Alektooo-222/zynq7020_ddr3_learning_board/(list of files, drawings)

Other design files:
DFTBoard.dsn
