Alektooo-222/zynq7020_ddr3_learning_board/DFTBoard.kicad_pcb

## KiCad design DFTBoard.kicad_pcb (2026-11-10)

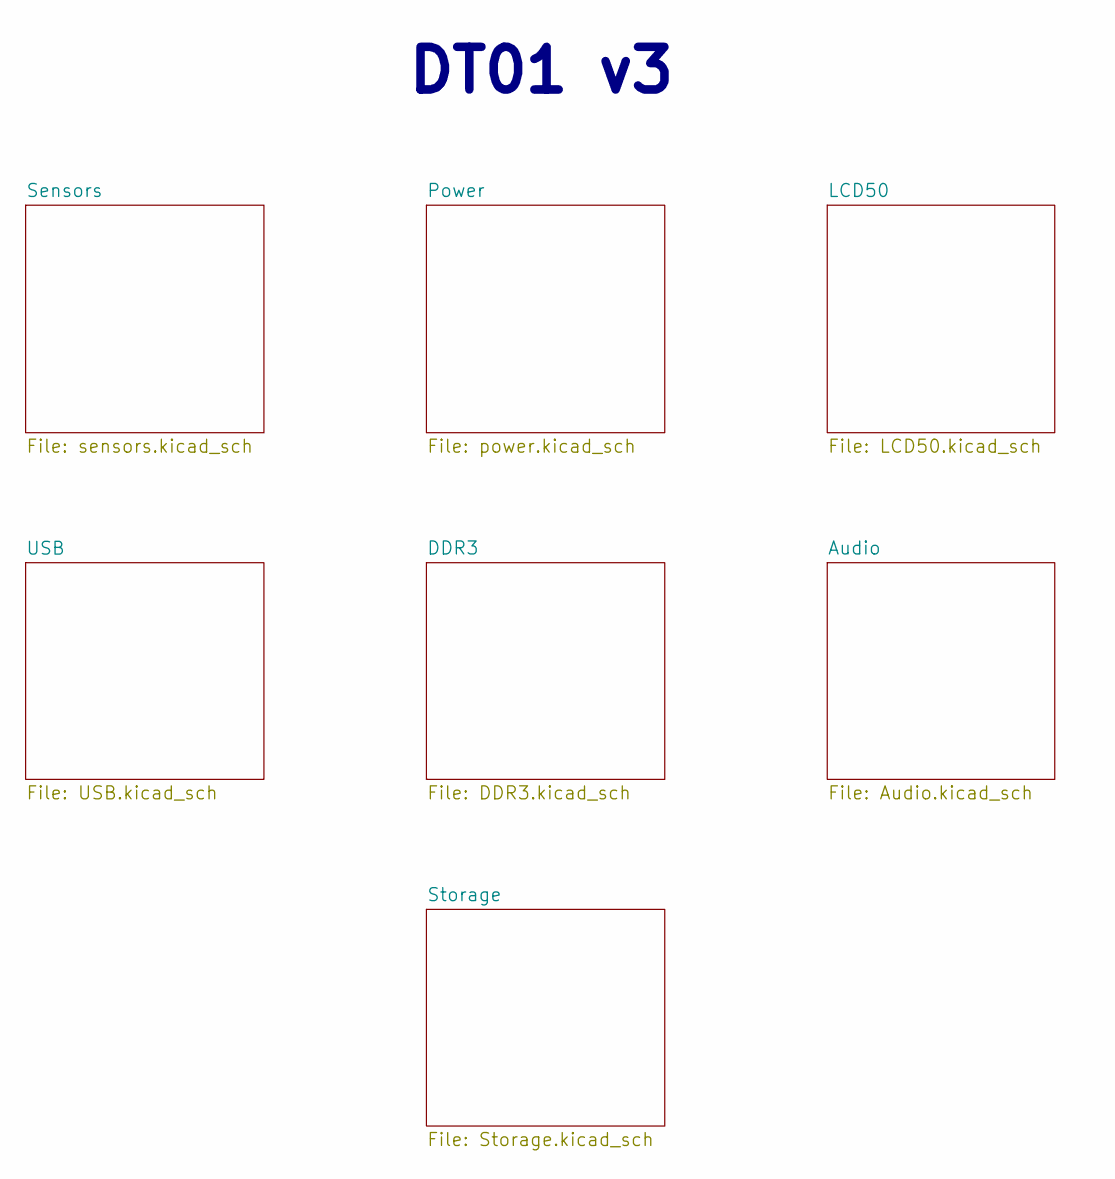
[picture p3: schematic DFTBoard.kicad_sch]

Notes on the sheet:
DT01 v3

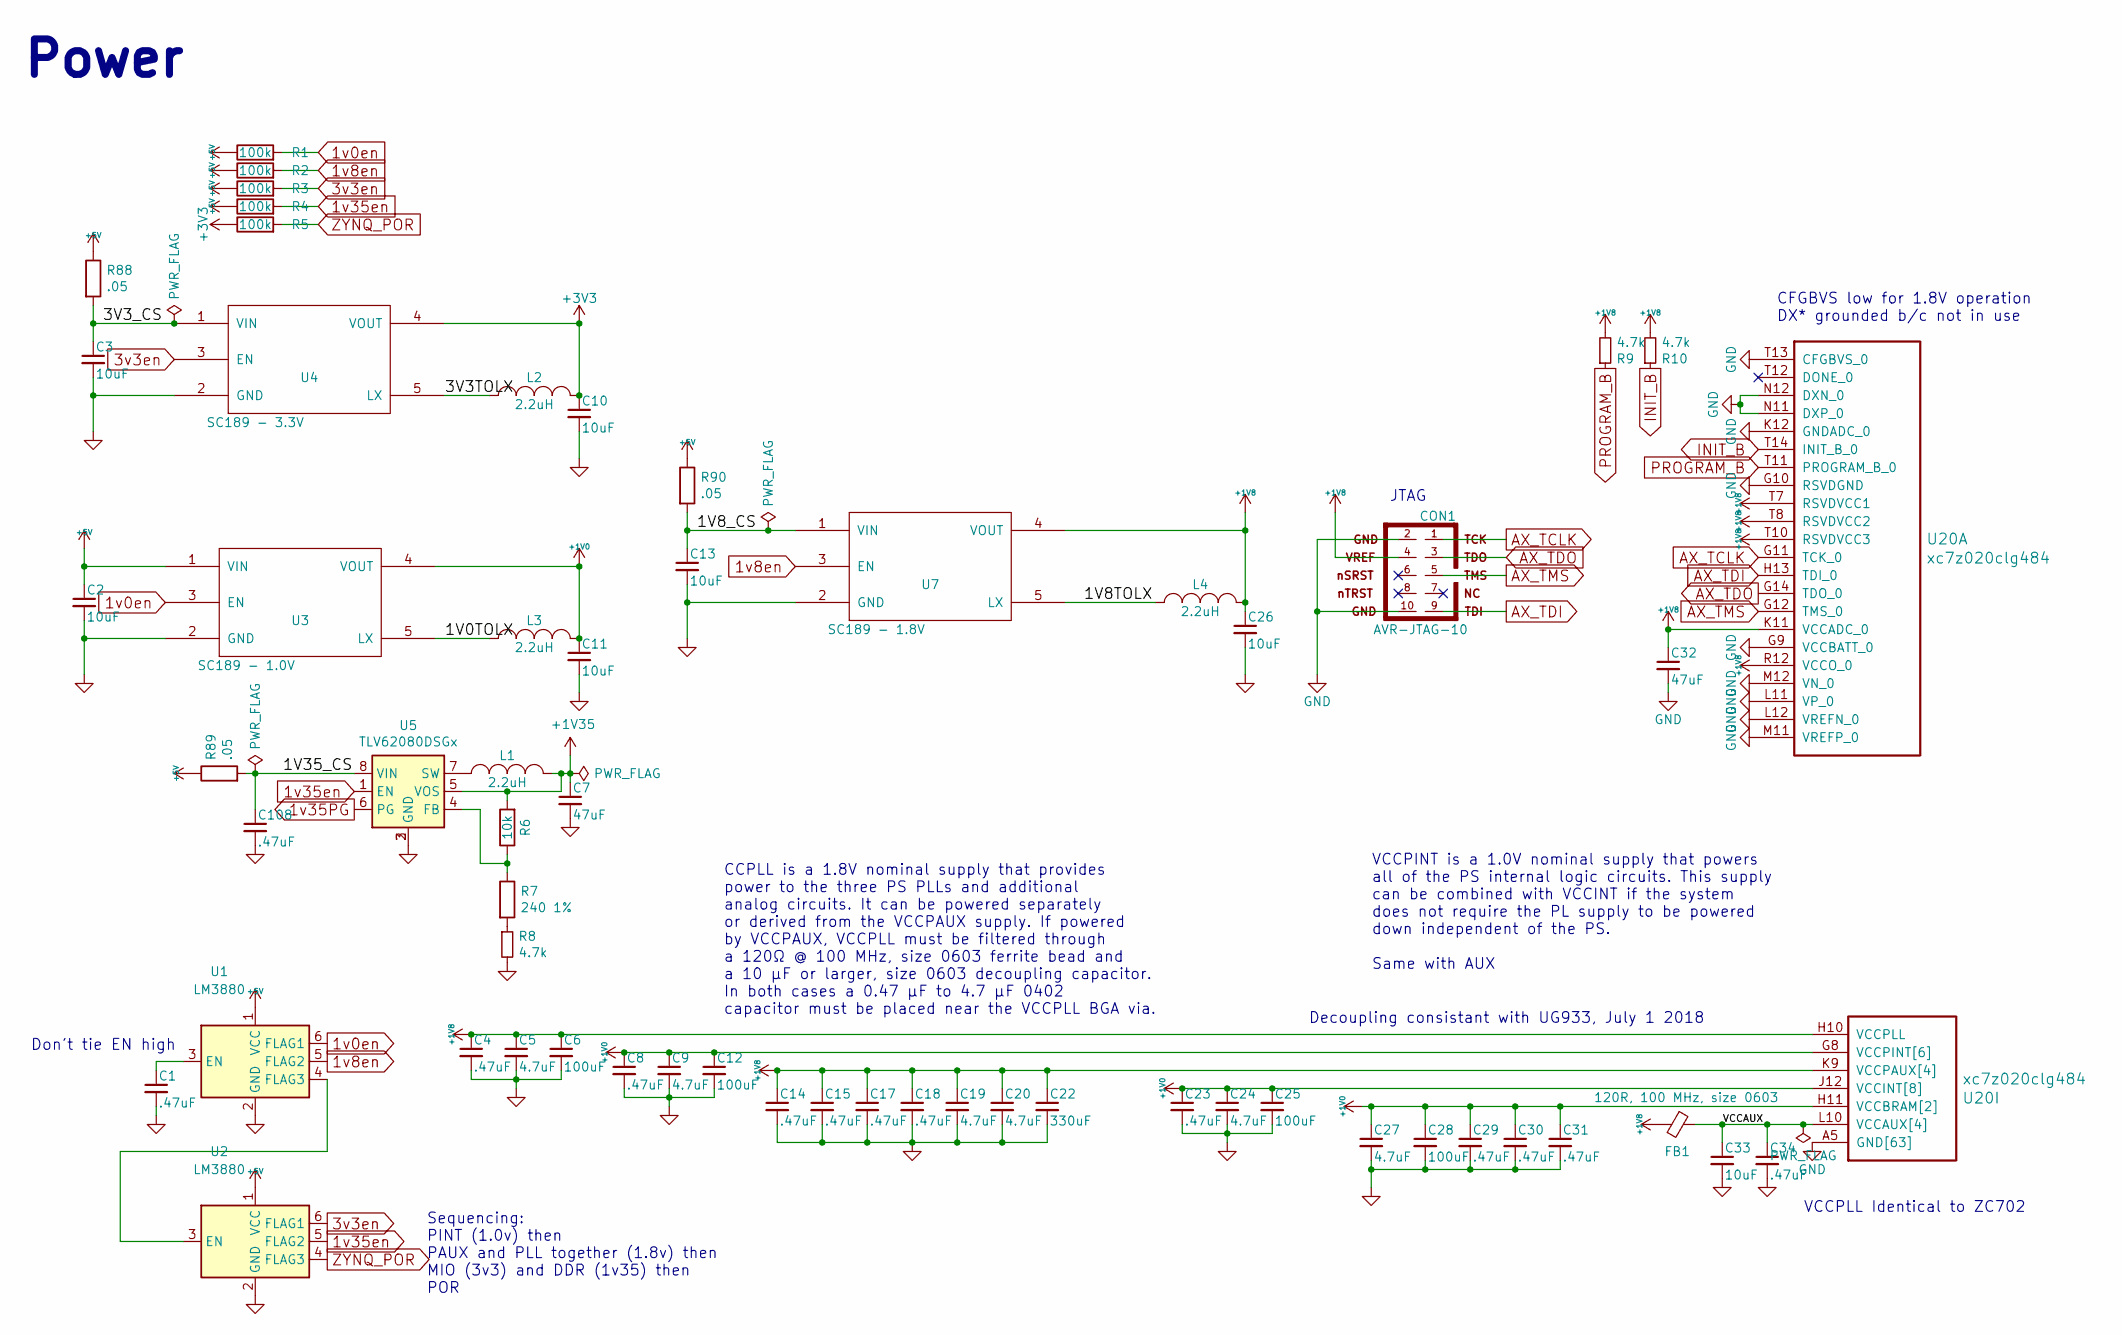
[picture p4: schematic power.kicad_sch]

Parts:
C1, C4, C8, C14, C15, C17, C18, C23, C29, C30, C31, C34, C108: .47uF; C_0402_1005Metric; MPN CC0402KRX5R5BB474
C2, C3, C10, C11, C13, C26, C33: 10uF; C_0603_1608Metric; MPN GRM188R61A106KE69J
C5, C9, C19, C20, C24, C27: 4.7uF; C_0402_1005Metric; MPN GRM155R60G475ME47D
C6, C12, C25, C28: 100uF; C_1210_3225Metric; MPN JMK325ABJ107MM-P
C7, C32: 47uF; C_0805_2012Metric; MPN GRM219R60J476ME44D
C22: 330uF; C_1206_3216Metric; MPN F950G337MAAAQ2
CON1: AVR-JTAG-10; XilinxJTAG
FB1: 120R, 100 MHz, size 0603; C_0603_1608Metric; MPN BLM18AG121SN1D
L1, L2, L3, L4: 2.2uH; C_1812_4532Metric; MPN LQH43PN2R2M26L
R1, R2, R3, R4, R5: 100k; R_0402_1005Metric; MPN RC0402FR-07100KL
R6: 10k; R_0402_1005Metric; MPN RC0402FR-0710KL
R7: 240 1%; R_0402_1005Metric; MPN RC0402FR-07240RL
R8, R9, R10: 4.7k; R_0402_1005Metric; MPN RC0402JR-074K7L
R88, R89, R90: .05; R_2512_6332Metric; MPN CRA2512-FZ-R050ELF
U1, U2: LM3880; SOT-23-6; MPN LM3880MF-1AE/NOPB
U3: SC189 - 1.0V; SOT-23-5; MPN SC189ASKTRT
U4: SC189 - 3.3V; SOT-23-5; MPN SC189ZSKTRT
U5: TLV62080DSGx; WSON-8-1EP_2x2mm_P0.5mm_EP0.9x1.6mm; MPN TLV62080DSGR
U7: SC189 - 1.8V; SOT-23-5; MPN SC189LSKTRT
U20: xc7z020clg484; BGA-484_19.0x19.0mm_Layout22x22_P0.80mm_dia0.40mm; MPN XC7Z020-1CLG484C

Connections:
1v0en: R1.2, U1.6 (FLAG1), U3.3 (EN)
1v8en: R2.2, U1.5 (FLAG2), U7.3 (EN)
1v35PG: U5.6 (PG); also elsewhere on the board
1v35en: R4.2, U2.5 (FLAG2), U5.1 (EN)
3v3en: R3.2, U2.6 (FLAG1), U4.3 (EN)
+1V0: C8.1, C9.1, C11.1, C12.1, C23.1, C24.1, C25.1, C27.1, C28.1, C29.1, C30.1, C31.1, L3.2, U3.4 (VOUT), U20.G8 (VCCPINT[6]), U20.H9 (VCCPINT[6]), U20.H11 (VCCBRAM[2]), U20.J8 (VCCPINT[6]), U20.J10 (VCCBRAM[2]), U20.J12 (VCCINT[8]), U20.J14 (VCCINT[8]), U20.K13 (VCCINT[8]), U20.L8 (VCCPINT[6]), U20.L14 (VCCINT[8]), U20.M13 (VCCINT[8]), U20.N8 (VCCPINT[6]), U20.N14 (VCCINT[8]), U20.P13 (VCCINT[8]), U20.R8 (VCCPINT[6]), U20.R14 (VCCINT[8])
+1V8: C4.1, C5.1, C6.1, C14.1, C15.1, C17.1, C18.1, C19.1, C20.1, C22.1, C26.1, C32.1, CON1.4, FB1.2, L4.2, R9.2, R10.2, U7.4 (VOUT), U20.H10 (VCCPLL), U20.K9 (VCCPAUX[4]), U20.K11 (VCCADC_0), U20.M9 (VCCPAUX[4]), U20.P9 (VCCPAUX[4]), U20.R12 (VCCO_0), U20.T7 (RSVDVCC1), U20.T8 (RSVDVCC2), U20.T9 (VCCPAUX[4]), U20.T10 (RSVDVCC3); also elsewhere on the board
+1V35: C7.1, L1.2, R6.2, U5.5 (VOS); also elsewhere on the board
+3V3: C10.1, L2.2, R5.1, U4.4 (VOUT); also elsewhere on the board
+5V: C2.1, R1.1, R2.1, R3.1, R4.1, R88.1, R89.1, R90.1, U1.1 (VCC), U2.1 (VCC), U3.1 (VIN); also elsewhere on the board
/Power/1V0TOLX: L3.1, U3.5 (LX)
/Power/1V8TOLX: L4.1, U7.5 (LX)
/Power/1V8_CS: C13.1, R90.2, U7.1 (VIN)
/Power/1V35_CS: C108.1, R89.2, U5.8 (VIN)
/Power/3V3TOLX: L2.1, U4.5 (LX)
/Power/3V3_CS: C3.1, R88.2, U4.1 (VIN)
/Power/VCCAUX: C33.1, C34.1, FB1.1, U20.L10 (VCCAUX[4]), U20.N10 (VCCAUX[4]), U20.P11 (VCCAUX[4]), U20.R10 (VCCAUX[4])
AX_TCLK: CON1.1, U20.G11 (TCK_0)
AX_TDI: CON1.9, U20.H13 (TDI_0)
AX_TDO: CON1.3, U20.G14 (TDO_0)
AX_TMS: CON1.5, U20.G12 (TMS_0)
GND: C1.2, C2.2, C3.2, C4.2, C5.2, C6.2, C7.2, C8.2, C9.2, C10.2, C11.2, C12.2, C13.2, C14.2, C15.2, C17.2, C18.2, C19.2, C20.2, C22.2, C23.2, C24.2, C25.2, C26.2, C27.2, C28.2, C29.2, C30.2, C31.2, C32.2, C33.2, C34.2, C108.2, CON1.2, CON1.10, R8.2, U1.2 (GND), U2.2 (GND), U3.2 (GND), U4.2 (GND), U5.2 (GND), U5.3 (GND), U5.9 (GND), U7.2 (GND), U20.A5 (GND[63]), U20.A15 (GND[63]), U20.AA5 (GND[63]), U20.AA15 (GND[63]), U20.AB8 (GND[63]), U20.AB18 (GND[63]), U20.B8 (GND[63]), U20.B18 (GND[63]), U20.C1 (GND[63]), U20.C11 (GND[63]), U20.C21 (GND[63]), U20.D4 (GND[63]), U20.D14 (GND[63]), U20.E7 (GND[63]), U20.E17 (GND[63]), U20.F10 (GND[63]), U20.F20 (GND[63]), U20.G3 (GND[63]), U20.G9 (VCCBATT_0), U20.G10 (RSVDGND), U20.H6 (GND[63]), U20.H8 (GND[63]), U20.H12 (GND[63]), U20.H14 (GND[63]), U20.H16 (GND[63]), U20.J9 (GND[63]), U20.J11 (GND[63]), U20.J13 (GND[63]), U20.J19 (GND[63]), U20.K2 (GND[63]), U20.K8 (GND[63]), U20.K10 (GND[63]), U20.K12 (GNDADC_0), U20.K14 (GND[63]), U20.K22 (GND[63]), U20.L5 (GND[63]), U20.L9 (GND[63]), U20.L11 (VP_0), U20.L12 (VREFN_0), U20.L13 (GND[63]), U20.L15 (GND[63]), U20.M8 (GND[63]), U20.M10 (GND[63]), U20.M11 (VREFP_0), U20.M12 (VN_0), U20.M14 (GND[63]), U20.M18 (GND[63]), U20.N1 (GND[63]), U20.N9 (GND[63]), U20.N11 (DXP_0), U20.N12 (DXN_0), U20.N13 (GND[63]), U20.N21 (GND[63]), U20.P4 (GND[63]), U20.P8 (GND[63]), U20.P10 (GND[63]), U20.P12 (GND[63]), U20.P14 (GND[63]), U20.R9 (GND[63]), U20.R11 (GND[63]), U20.R13 (GND[63]), U20.R17 (GND[63]), U20.T13 (CFGBVS_0), U20.T20 (GND[63]), U20.U3 (GND[63]), U20.U13 (GND[63]), U20.V6 (GND[63]), U20.V16 (GND[63]), U20.W9 (GND[63]), U20.W19 (GND[63]), U20.Y2 (GND[63]), U20.Y12 (GND[63]), U20.Y22 (GND[63]); also elsewhere on the board
INIT_B: R10.1, U20.T14 (INIT_B_0)
unnamed: R7.2, R8.1
unnamed: C1.1, U1.3 (EN)
unnamed: U1.4 (FLAG3), U2.3 (EN)
unnamed: R6.1, R7.1, U5.4 (FB)
unnamed: L1.1, U5.7 (SW)
PROGRAM_B: R9.1, U20.T11 (PROGRAM_B_0)
ZYNQ_POR: R5.2, U2.4 (FLAG3); also elsewhere on the board

Notes on the sheet:
VCCPINT is a 1.0V nominal supply that powers all of the PS internal logic circuits. This supply can be combined with VCCINT if the system does not require the PL supply to be powered down independent of the PS. Same with AUX
Decoupling consistant with UG933, July 1 2018
VCCPLL Identical to ZC702
Don't tie EN high
Power
JTAG
CCPLL is a 1.8V nominal supply that provides power to the three PS PLLs and additional analog circuits. It can be powered separately or derived from the VCCPAUX supply. If powered by VCCPAUX, VCCPLL must be filtered through a 120Ω @ 100 MHz, size 0603 ferrite bead and a 10 µF or larger, size 0603 d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
Sequencing: PINT (1.0v) then PAUX and PLL together (1.8v) then MIO (3v3) and DDR (1v35) then POR
CFGBVS low for 1.8V operation DX* grounded b/c not in use

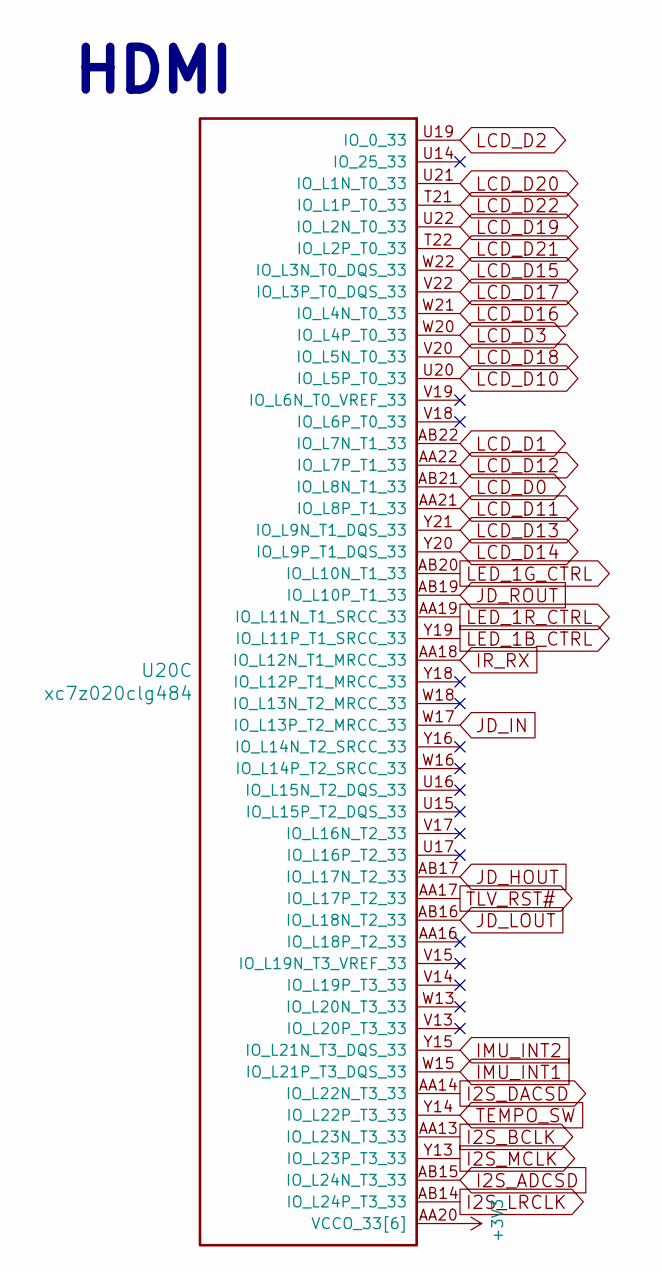
[picture p5: schematic Audio.kicad_sch]

Parts:
U20: xc7z020clg484; BGA-484_19.0x19.0mm_Layout22x22_P0.80mm_dia0.40mm; MPN XC7Z020-1CLG484C

Connections:
+3V3: U20.AA20 (VCCO_33[6]), U20.AB13 (VCCO_33[6]), U20.U18 (VCCO_33[6]), U20.V21 (VCCO_33[6]), U20.W14 (VCCO_33[6]), U20.Y17 (VCCO_33[6]); also elsewhere on the board
I2S_ADCSD: U20.AB15 (IO_L24N_T3_33)
I2S_BCLK: U20.AA13 (IO_L23N_T3_33)
I2S_DACSD: U20.AA14 (IO_L22N_T3_33)
I2S_LRCLK: U20.AB14 (IO_L24P_T3_33)
I2S_MCLK: U20.Y13 (IO_L23P_T3_33)
IMU_INT1: U20.W15 (IO_L21P_T3_DQS_33); also elsewhere on the board
IMU_INT2: U20.Y15 (IO_L21N_T3_DQS_33); also elsewhere on the board
IR_RX: U20.AA18 (IO_L12N_T1_MRCC_33); also elsewhere on the board
JD_HOUT: U20.AB17 (IO_L17N_T2_33)
JD_IN: U20.W17 (IO_L13P_T2_MRCC_33)
JD_LOUT: U20.AB16 (IO_L18N_T2_33)
JD_ROUT: U20.AB19 (IO_L10P_T1_33)
LCD_D0: U20.AB21 (IO_L8N_T1_33)
LCD_D1: U20.AB22 (IO_L7N_T1_33)
LCD_D2: U20.U19 (IO_0_33)
LCD_D3: U20.W20 (IO_L4P_T0_33)
LCD_D10: U20.U20 (IO_L5P_T0_33)
LCD_D11: U20.AA21 (IO_L8P_T1_33)
LCD_D12: U20.AA22 (IO_L7P_T1_33)
LCD_D13: U20.Y21 (IO_L9N_T1_DQS_33)
LCD_D14: U20.Y20 (IO_L9P_T1_DQS_33)
LCD_D15: U20.W22 (IO_L3N_T0_DQS_33)
LCD_D16: U20.W21 (IO_L4N_T0_33)
LCD_D17: U20.V22 (IO_L3P_T0_DQS_33)
LCD_D18: U20.V20 (IO_L5N_T0_33)
LCD_D19: U20.U22 (IO_L2N_T0_33)
LCD_D20: U20.U21 (IO_L1N_T0_33)
LCD_D21: U20.T22 (IO_L2P_T0_33)
LCD_D22: U20.T21 (IO_L1P_T0_33)
LED_1B_CTRL: U20.Y19 (IO_L11P_T1_SRCC_33)
LED_1G_CTRL: U20.AB20 (IO_L10N_T1_33)
LED_1R_CTRL: U20.AA19 (IO_L11N_T1_SRCC_33)
TEMPO_SW: U20.Y14 (IO_L22P_T3_33); also elsewhere on the board
TLV_RST#: U20.AA17 (IO_L17P_T2_33)

Notes on the sheet:
HDMI

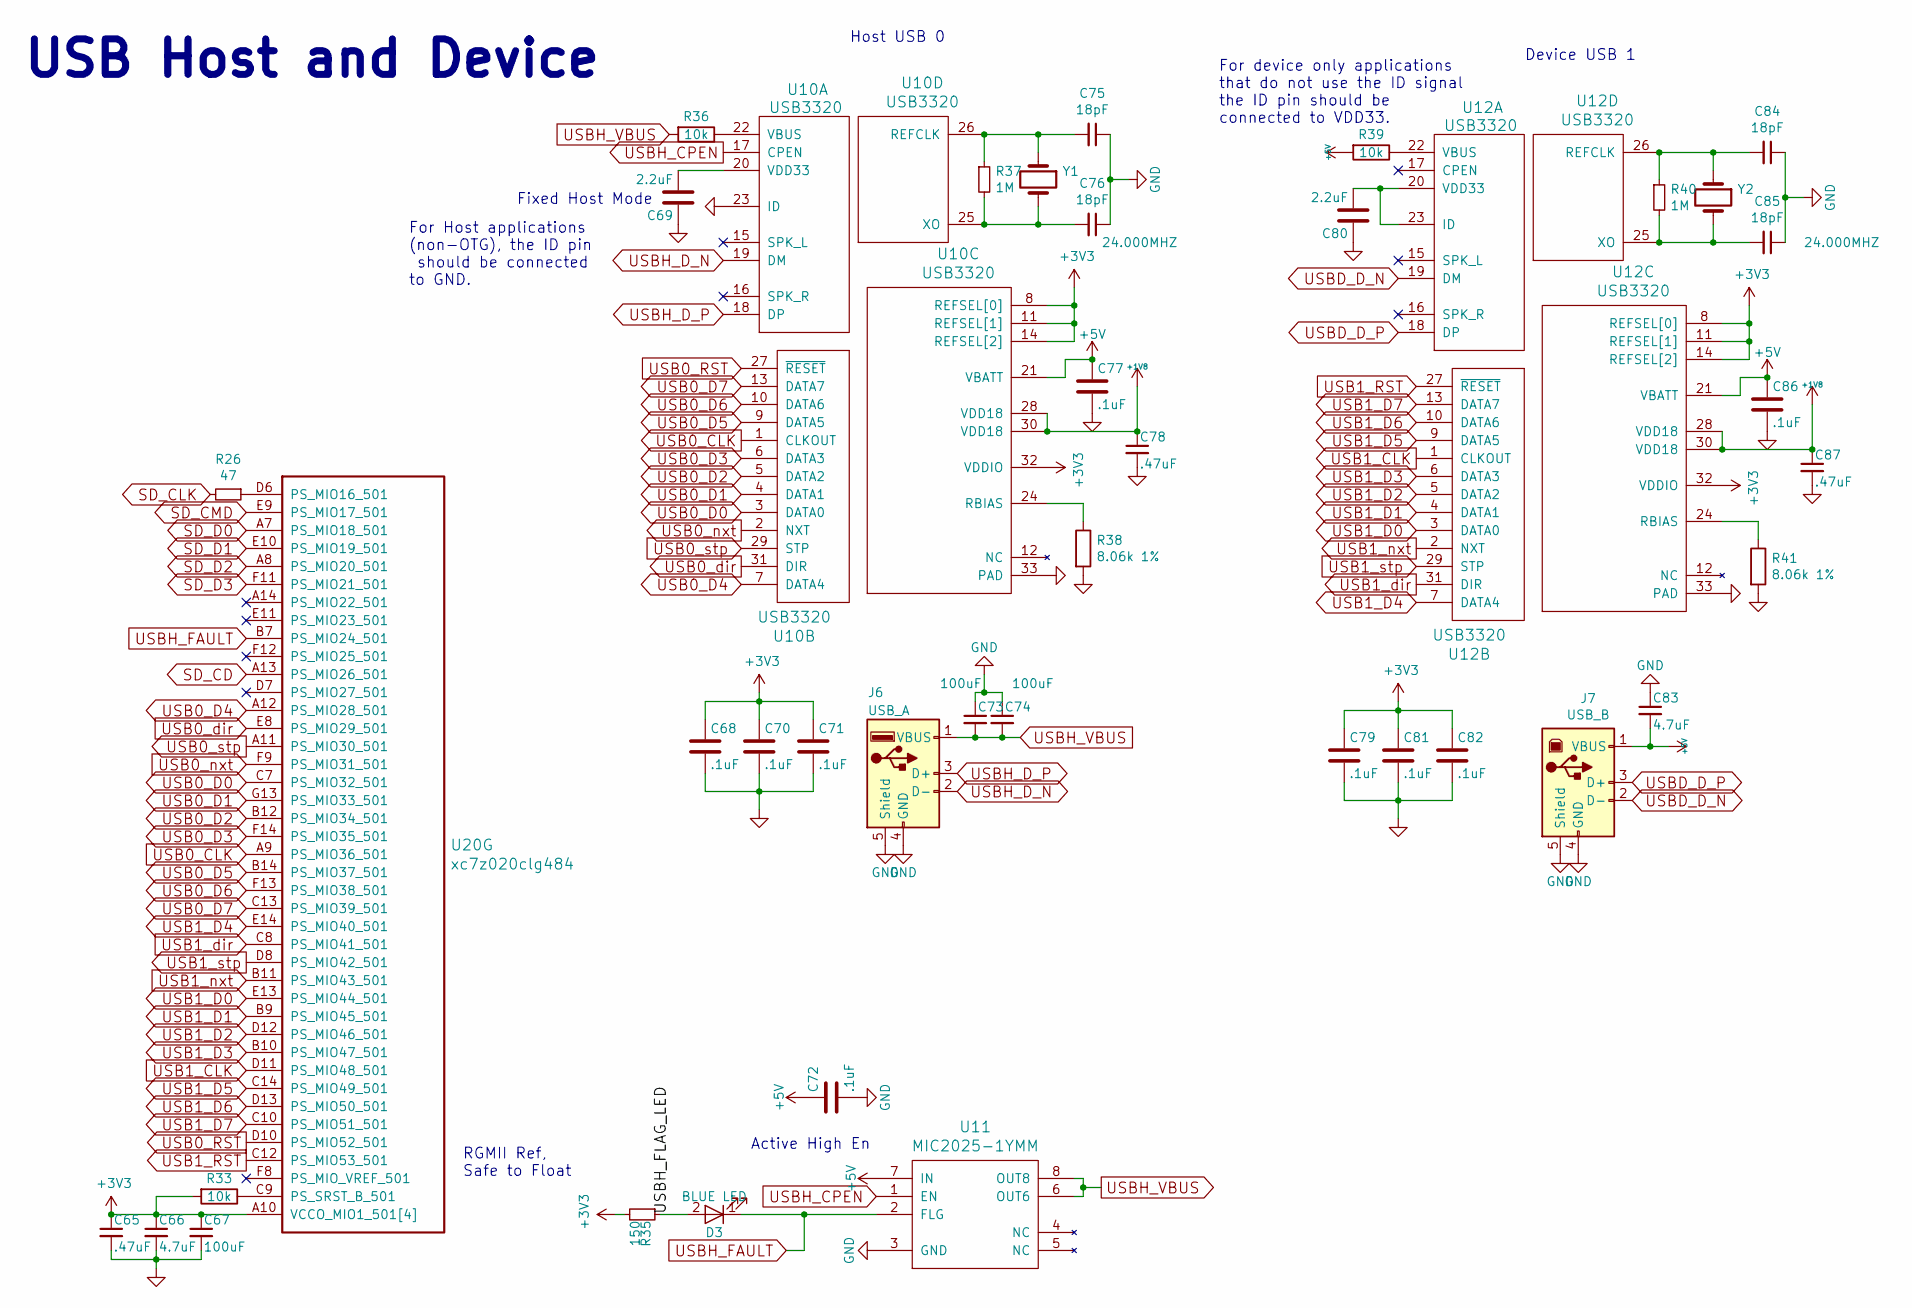
[picture p6: schematic USB.kicad_sch]

Parts:
C65, C78, C87: .47uF; C_0402_1005Metric; MPN CC0402KRX5R5BB474
C66, C83: 4.7uF; C_0402_1005Metric; MPN GRM155R60G475ME47D
C67, C73, C74: 100uF; C_1210_3225Metric; MPN JMK325ABJ107MM-P
C68, C70, C71, C72, C77, C79, C81, C82, C86: .1uF; C_0402_1005Metric; MPN CC0402KRX7R6BB104
C69, C80: 2.2uF; C_0402_1005Metric; MPN GRM155R61A225KE95D
C75, C76, C84, C85: 18pF; C_0402_1005Metric; MPN GCM1555C1H180JA16D
D3: BLUE LED; C_0603_1608Metric; MPN VLMB1300-GS08
J6: USB_A; USB-A-Receptacle-FCI_87583; MPN 87583-2010RLF
J7: USB_B; USB_B_OST_USB-B1HSxx_Horizontal; MPN USB-B1HSW6
R26: 47; R_0402_1005Metric; MPN RC0402JR-0747RL
R33, R36, R39: 10k; R_0402_1005Metric; MPN RC0402FR-0710KL
R35: 150; R_0402_1005Metric; MPN RC0402FR-07150RL
R37, R40: 1M; R_0402_1005Metric; MPN RC0402FR-071ML
R38, R41: 8.06k 1%; R_0402_1005Metric; MPN RC0402FR-078K06L
U10, U12: USB3320; QFN-32-1EP_5x5mm_P0.5mm_EP3.1x3.1mm; MPN USB3320C-EZK-TR
U11: MIC2025-1YMM; SOP65P490X110-8N; MPN MIC2025-1YMM-TR
U20: xc7z020clg484; BGA-484_19.0x19.0mm_Layout22x22_P0.80mm_dia0.40mm; MPN XC7Z020-1CLG484C
Y1, Y2: 24.000MHZ; XTAL500X320X130N; MPN ABM3-24.000MHZ-D2Y-T

Connections:
+1V8: C78.1, C87.1, U10.28 (VDD18), U10.30 (VDD18), U12.28 (VDD18), U12.30 (VDD18); also elsewhere on the board
+3V3: C65.1, C66.1, C67.1, C68.1, C70.1, C71.1, C79.1, C81.1, C82.1, R33.2, R35.2, U10.8 (REFSEL[0]), U10.11 (REFSEL[1]), U10.14 (REFSEL[2]), U10.32 (VDDIO), U12.8 (REFSEL[0]), U12.11 (REFSEL[1]), U12.14 (REFSEL[2]), U12.32 (VDDIO), U20.A10 (VCCO_MIO1_501[4]), U20.B13 (VCCO_MIO1_501[4]), U20.D9 (VCCO_MIO1_501[4]), U20.E12 (VCCO_MIO1_501[4]); also elsewhere on the board
+5V: C72.1, C77.1, C83.2, C86.1, J7.1 (VBUS), R39.2, U10.21 (VBATT), U11.7 (IN), U12.21 (VBATT); also elsewhere on the board
/USB/USBH_FLAG_LED: D3.2 (A), R35.1
GND: C65.2, C66.2, C67.2, C68.2, C69.1, C70.2, C71.2, C72.2, C73.1, C74.1, C75.1, C76.1, C77.2, C78.2, C79.2, C80.1, C81.2, C82.2, C83.1, C84.1, C85.1, C86.2, C87.2, J6.4 (GND), J6.5 (Shield), J7.4 (GND), J7.5 (Shield), R38.2, R41.2, U10.23 (ID), U10.33 (PAD), U11.3 (GND), U12.33 (PAD); also elsewhere on the board
unnamed: R36.1, U10.22 (VBUS)
unnamed: C69.2, U10.20 (VDD33)
unnamed: R38.1, U10.24 (RBIAS)
unnamed: C75.2, R37.1, U10.26 (REFCLK), Y1.1
unnamed: C76.2, R37.2, U10.25 (XO), Y1.2
unnamed: C80.2, U12.20 (VDD33), U12.23 (ID)
unnamed: R39.1, U12.22 (VBUS)
unnamed: R41.1, U12.24 (RBIAS)
unnamed: C84.2, R40.1, U12.26 (REFCLK), Y2.1
unnamed: C85.2, R40.2, U12.25 (XO), Y2.2
unnamed: R26.1, U20.D6 (PS_MIO16_501)
unnamed: R33.1, U20.C9 (PS_SRST_B_501)
SD_CD: U20.A13 (PS_MIO26_501); also elsewhere on the board
SD_CLK: R26.2; also elsewhere on the board
SD_CMD: U20.E9 (PS_MIO17_501); also elsewhere on the board
SD_D0: U20.A7 (PS_MIO18_501); also elsewhere on the board
SD_D1: U20.E10 (PS_MIO19_501); also elsewhere on the board
SD_D2: U20.A8 (PS_MIO20_501); also elsewhere on the board
SD_D3: U20.F11 (PS_MIO21_501); also elsewhere on the board
USB0_CLK: U10.1 (CLKOUT), U20.A9 (PS_MIO36_501)
USB0_D0: U10.3 (DATA0), U20.C7 (PS_MIO32_501)
USB0_D1: U10.4 (DATA1), U20.G13 (PS_MIO33_501)
USB0_D2: U10.5 (DATA2), U20.B12 (PS_MIO34_501)
USB0_D3: U10.6 (DATA3), U20.F14 (PS_MIO35_501)
USB0_D4: U10.7 (DATA4), U20.A12 (PS_MIO28_501)
USB0_D5: U10.9 (DATA5), U20.B14 (PS_MIO37_501)
USB0_D6: U10.10 (DATA6), U20.F13 (PS_MIO38_501)
USB0_D7: U10.13 (DATA7), U20.C13 (PS_MIO39_501)
USB0_RST: U10.27 (~RESET), U20.D10 (PS_MIO52_501)
USB0_dir: U10.31 (DIR), U20.E8 (PS_MIO29_501)
USB0_nxt: U10.2 (NXT), U20.F9 (PS_MIO31_501)
USB0_stp: U10.29 (STP), U20.A11 (PS_MIO30_501)
USB1_CLK: U12.1 (CLKOUT), U20.D11 (PS_MIO48_501)
USB1_D0: U12.3 (DATA0), U20.E13 (PS_MIO44_501)
USB1_D1: U12.4 (DATA1), U20.B9 (PS_MIO45_501)
USB1_D2: U12.5 (DATA2), U20.D12 (PS_MIO46_501)
USB1_D3: U12.6 (DATA3), U20.B10 (PS_MIO47_501)
USB1_D4: U12.7 (DATA4), U20.E14 (PS_MIO40_501)
USB1_D5: U12.9 (DATA5), U20.C14 (PS_MIO49_501)
USB1_D6: U12.10 (DATA6), U20.D13 (PS_MIO50_501)
USB1_D7: U12.13 (DATA7), U20.C10 (PS_MIO51_501)
USB1_RST: U12.27 (~RESET), U20.C12 (PS_MIO53_501)
USB1_dir: U12.31 (DIR), U20.C8 (PS_MIO41_501)
USB1_nxt: U12.2 (NXT), U20.B11 (PS_MIO43_501)
USB1_stp: U12.29 (STP), U20.D8 (PS_MIO42_501)
USBD_D_N: J7.2 (D-), U12.19 (DM)
USBD_D_P: J7.3 (D+), U12.18 (DP)
USBH_CPEN: U10.17 (CPEN), U11.1 (EN)
USBH_D_N: J6.2 (D-), U10.19 (DM)
USBH_D_P: J6.3 (D+), U10.18 (DP)
USBH_FAULT: D3.1 (K), U11.2 (FLG), U20.B7 (PS_MIO24_501)
USBH_VBUS: C73.2, C74.2, J6.1 (VBUS), R36.2, U11.6 (OUT6), U11.8 (OUT8)

Notes on the sheet:
RGMII Ref, Safe to Float
Active High En
Host USB 0
For device only applications that do not use the ID signal the ID pin should be connected to VDD33.
Fixed Host Mode
Device USB 1
USB Host and Device
For Host applications (non-OTG), the ID pin should be connected to GND.

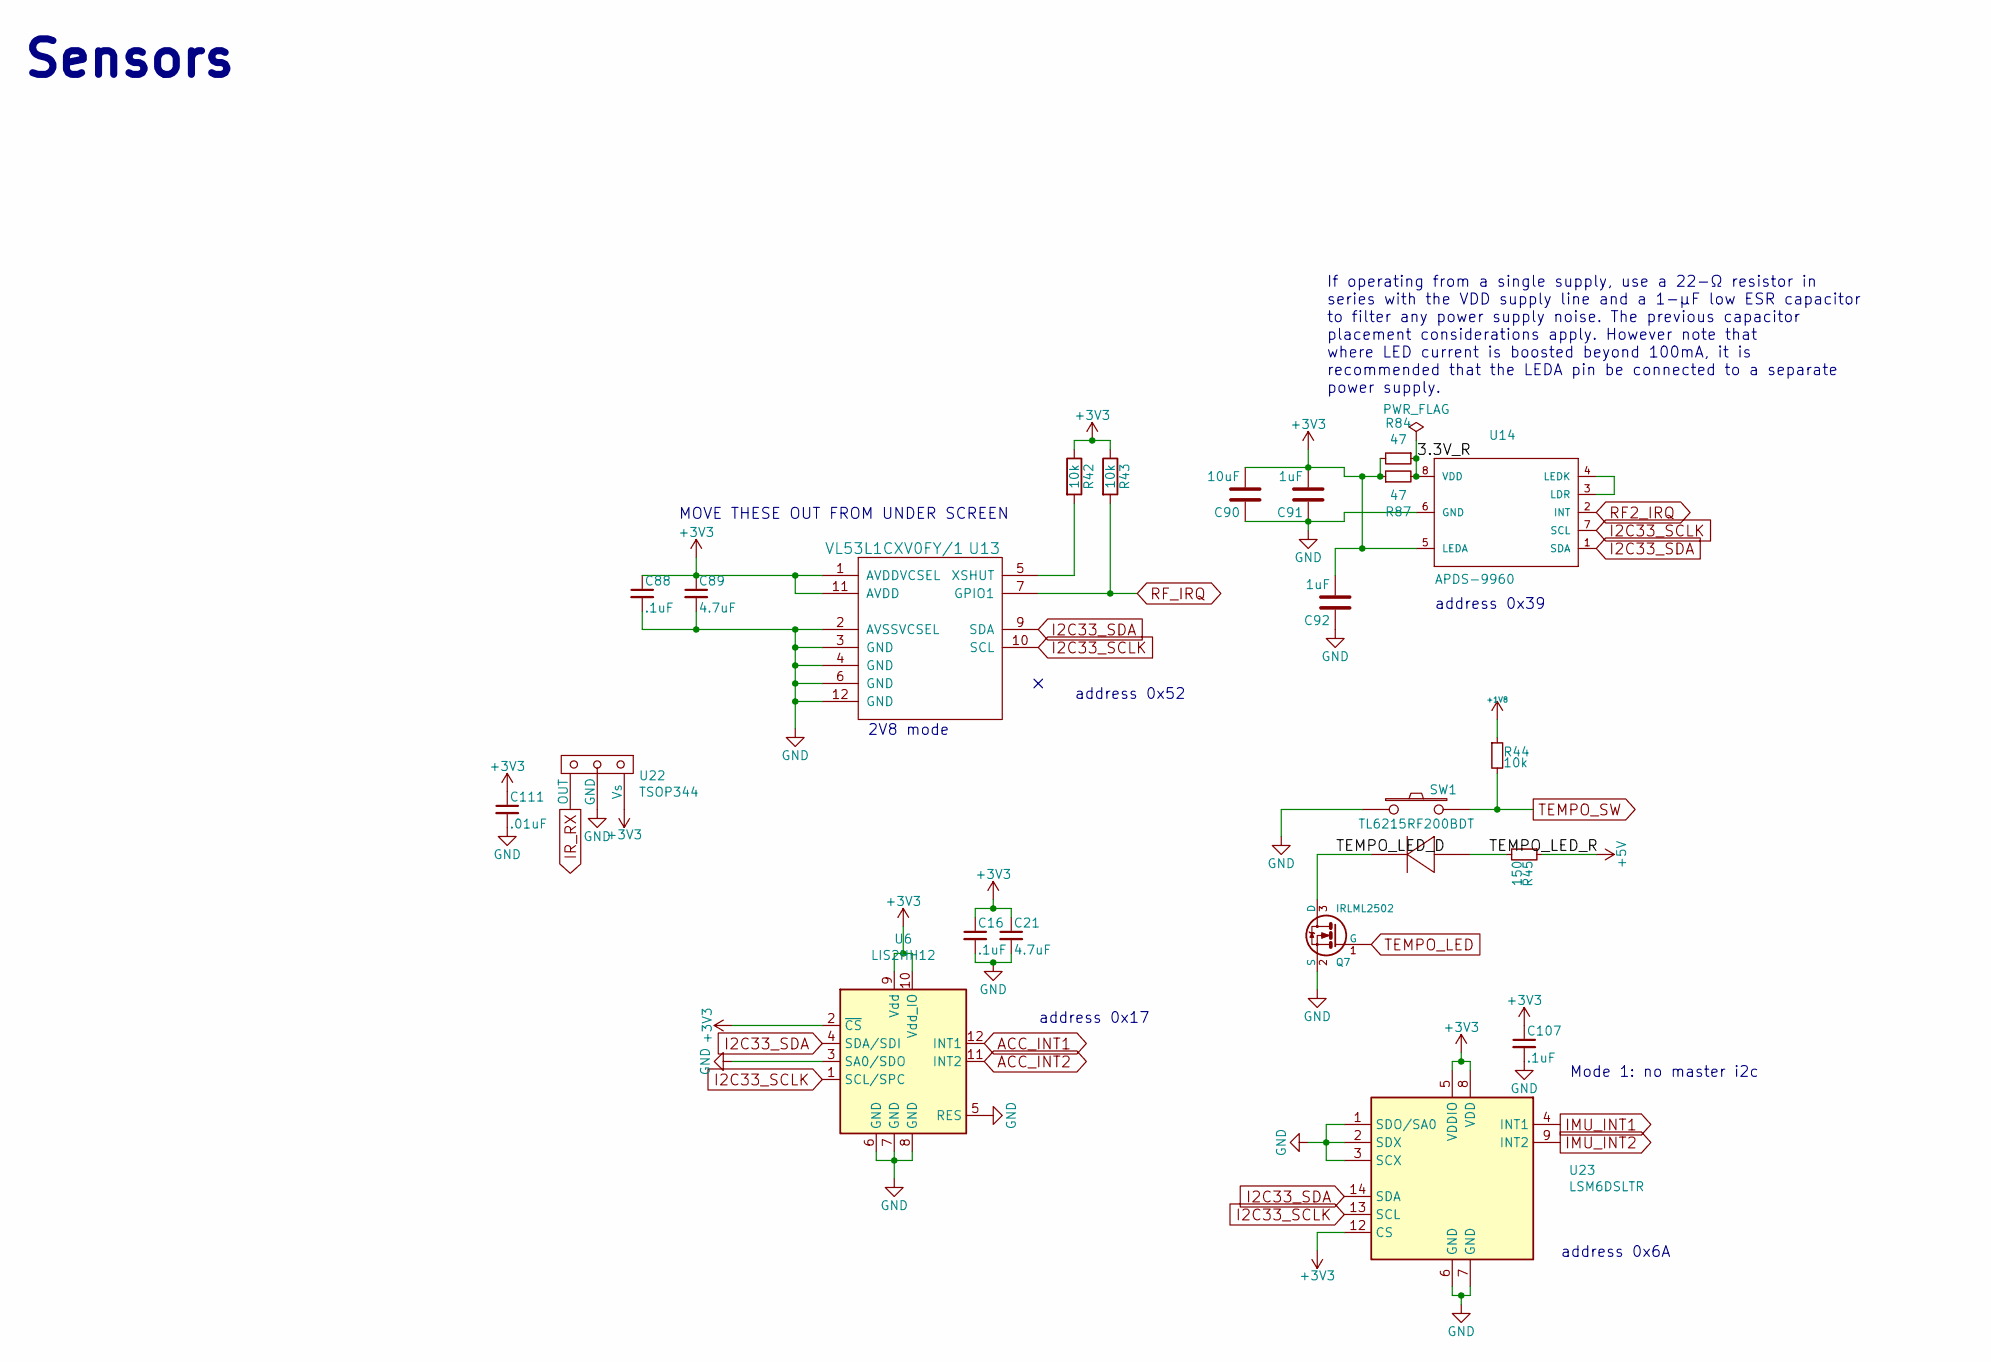
[picture p7: schematic sensors.kicad_sch]

Parts:
C16, C88, C107: .1uF; C_0402_1005Metric; MPN CC0402KRX7R6BB104
C21, C89: 4.7uF; C_0402_1005Metric; MPN GRM155R60G475ME47D
C90: 10uF; C_0603_1608Metric; MPN GRM188R61A106KE69J
C91, C92: 1uF; C_0402_1005Metric; MPN CC0402KRX5R6BB105
C111: .01uF; C_0402_1005Metric; MPN GRM155R71H103KA88J
Q7: IRLML2502; SOT-23; MPN IRLML2502TRPBF
R42, R43, R44: 10k; R_0402_1005Metric; MPN RC0402FR-0710KL
R45: 150; R_0402_1005Metric; MPN RC0402FR-07150RL
R84, R87: 47; R_0402_1005Metric; MPN RC0402JR-0747RL
SW1: TL6215RF200BDT; tl6215_right_angle; MPN TL6215RF200BDT
U6: LIS2HH12; LGA-12_2x2mm_P0.5mm; MPN LIS2HH12TR
U13: VL53L1CXV0FY/1; Optical_LGA12; MPN VL53L1CXV0FY/1
U14: APDS-9960; APDS_9960; MPN APDS-9960
U22: TSOP344; JUMPER_3PIN; MPN TSOP34438
U23: LSM6DSLTR; LGA-14_3x2.5mm_P0.5mm_LayoutBorder3x4y; MPN LSM6DSLTR

Connections:
+1V8: R44.1; also elsewhere on the board
+3V3: C16.1, C21.1, C88.1, C89.1, C90.2, C91.2, C92.2, C107.1, C111.1, R42.1, R43.1, R84.2, R87.1, U6.2 (~CS), U6.9 (Vdd), U6.10 (Vdd_IO), U13.1 (AVDDVCSEL), U13.11 (AVDD), U14.5 (LEDA), U22.3 (Vs), U23.5 (VDDIO), U23.8 (VDD), U23.12 (CS); also elsewhere on the board
+5V: R45.1; also elsewhere on the board
/Sensors/3.3V_R: R84.1, R87.2, U14.8 (VDD)
/Sensors/TEMPO_LED_D: Q7.3 (D), SW1.3
/Sensors/TEMPO_LED_R: R45.2, SW1.4
ACC_INT1: U6.12 (INT1); also elsewhere on the board
ACC_INT2: U6.11 (INT2); also elsewhere on the board
GND: C16.2, C21.2, C88.2, C89.2, C90.1, C91.1, C92.1, C107.2, C111.2, Q7.2 (S), SW1.1, U6.3 (SA0/SDO), U6.5 (RES), U6.6 (GND), U6.7 (GND), U6.8 (GND), U13.2 (AVSSVCSEL), U13.3 (GND), U13.4 (GND), U13.6 (GND), U13.12 (GND), U14.6 (GND), U22.2 (GND), U23.1 (SDO/SA0), U23.2 (SDX), U23.3 (SCX), U23.6 (GND), U23.7 (GND); also elsewhere on the board
I2C33_SCLK: U6.1 (SCL/SPC), U13.10 (SCL), U14.7 (SCL), U23.13 (SCL); also elsewhere on the board
I2C33_SDA: U6.4 (SDA/SDI), U13.9 (SDA), U14.1 (SDA), U23.14 (SDA); also elsewhere on the board
IMU_INT1: U23.4 (INT1); also elsewhere on the board
IMU_INT2: U23.9 (INT2); also elsewhere on the board
IR_RX: U22.1 (OUT); also elsewhere on the board
unnamed: R42.2, U13.5 (XSHUT)
unnamed: U14.3 (LDR), U14.4 (LEDK)
RF2_IRQ: U14.2 (INT); also elsewhere on the board
RF_IRQ: R43.2, U13.7 (GPIO1); also elsewhere on the board
TEMPO_LED: Q7.1 (G); also elsewhere on the board
TEMPO_SW: R44.2, SW1.2; also elsewhere on the board

Notes on the sheet:
address 0x39
address 0x52
MOVE THESE OUT FROM UNDER SCREEN
If operating from a single supply, use a 22-Ω resistor in series with the VDD supply line and a 1-μF low ESR capacitor to filter any power supply noise. The previous capacitor placement considerations apply. However note that where LED current is boosted beyond 100mA, it is recommended that the LED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
address 0x17
address 0x6A
Mode 1: no master i2c
Sensors
2V8 mode
