Alektooo-222/zynq7020_ddr3_learning_board/DFTBoard.kicad_pcb

## KiCad design DFTBoard.kicad_pcb (continued)

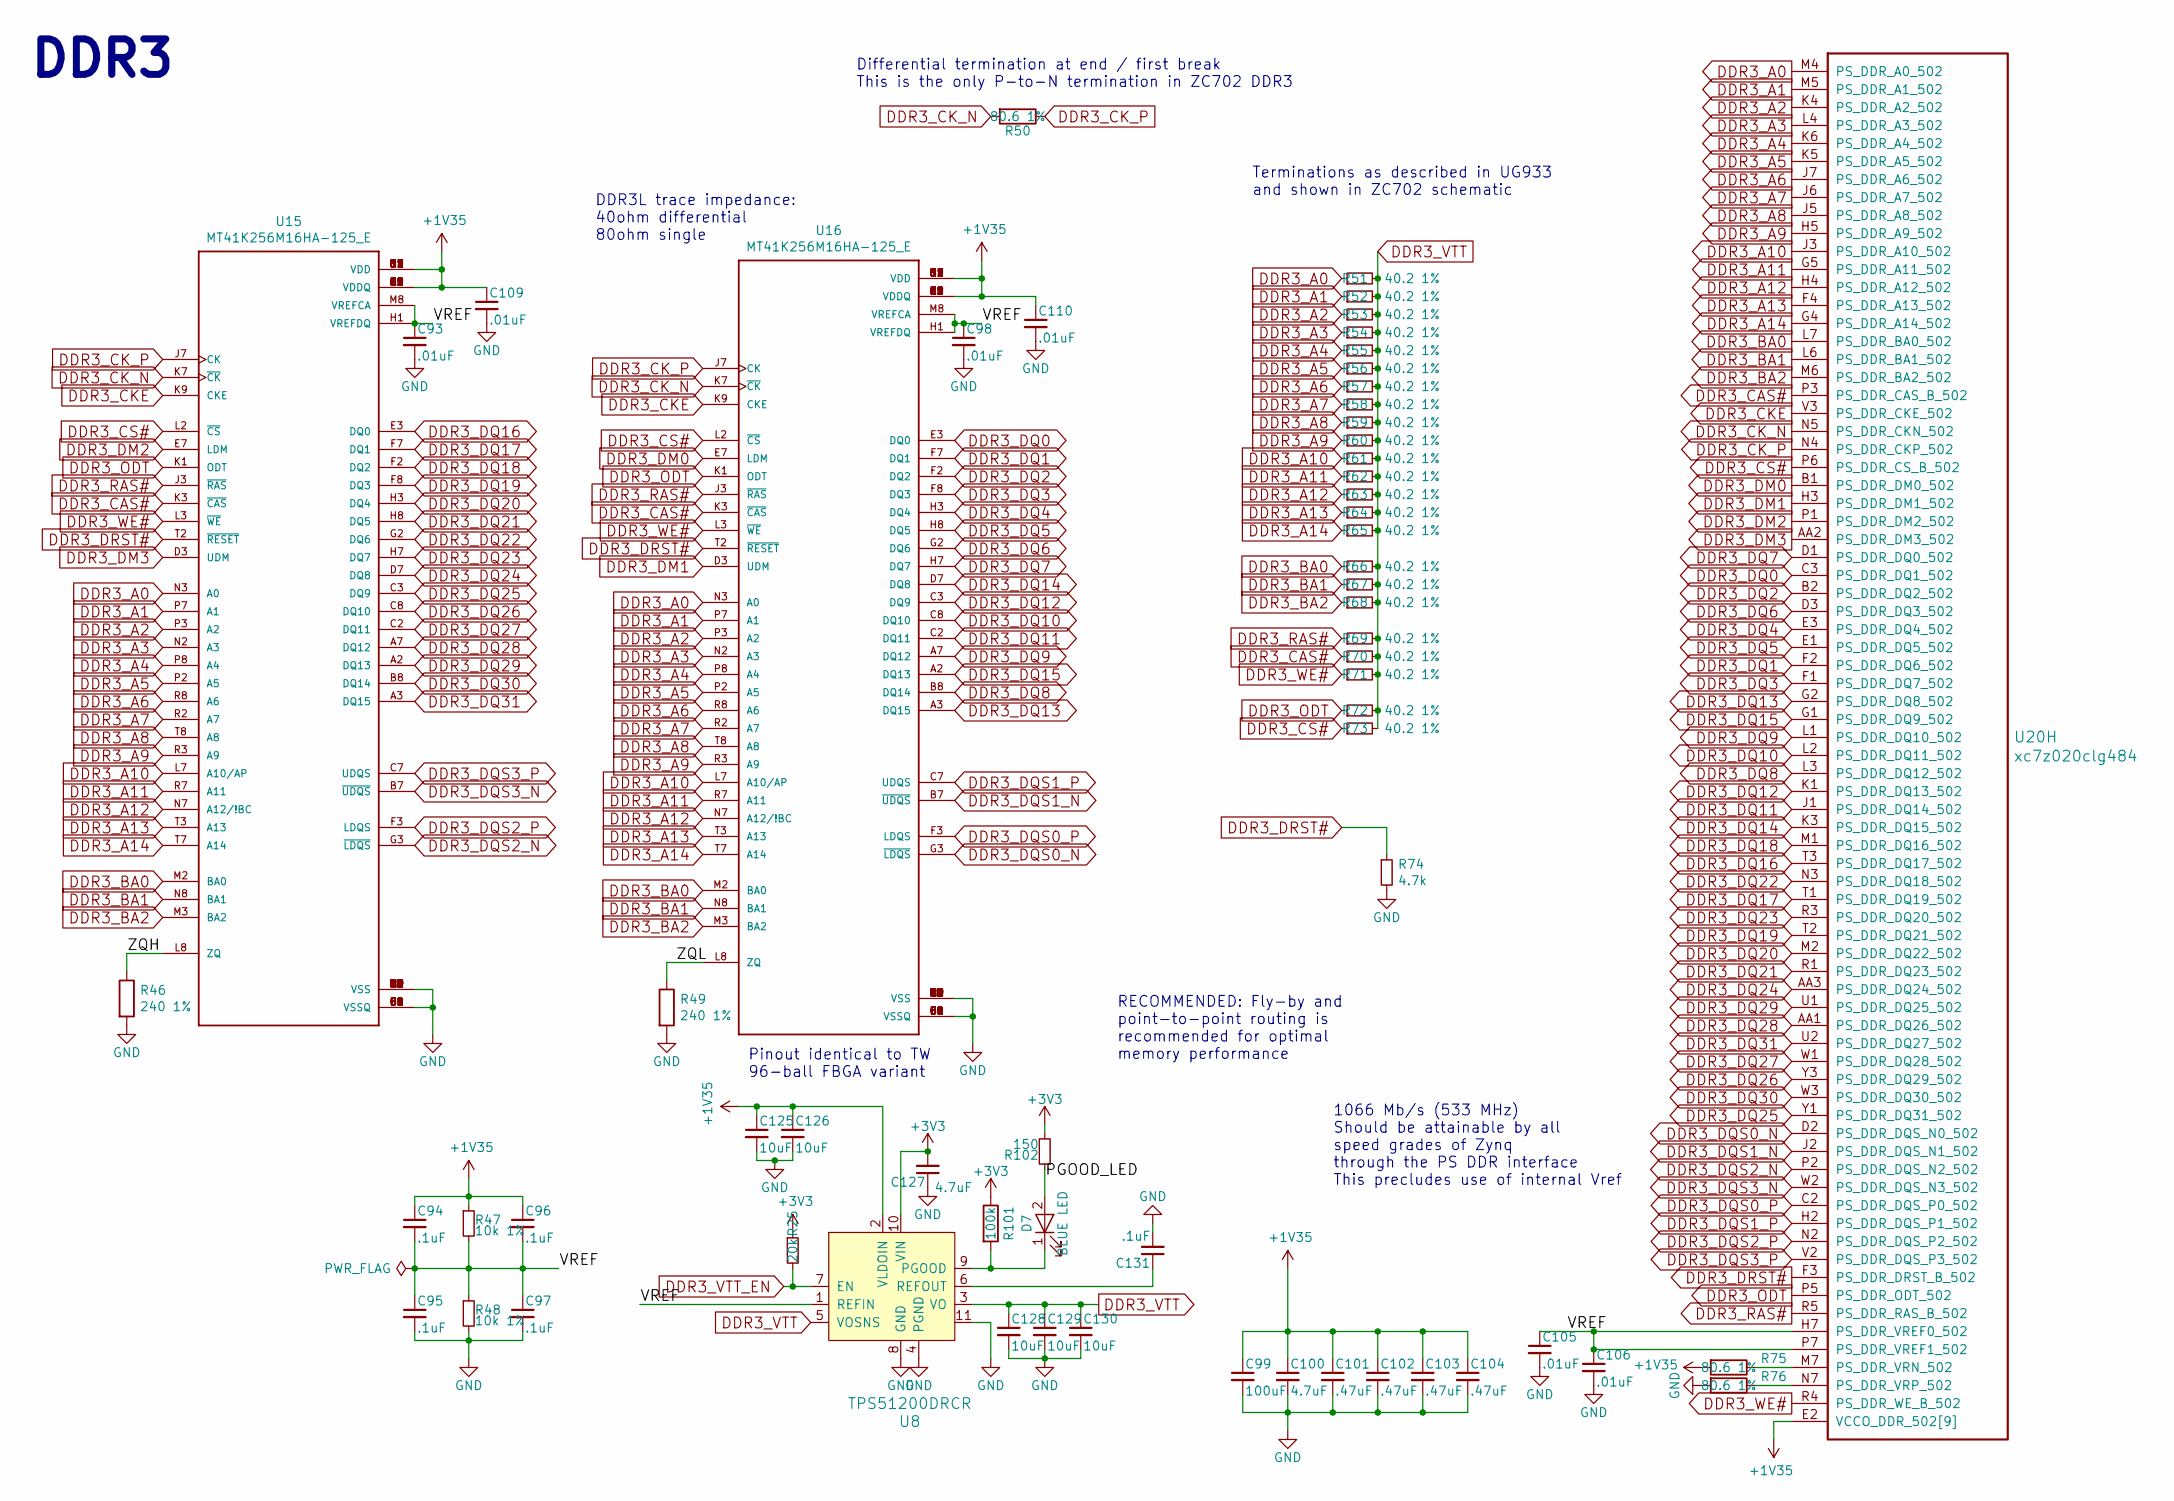
[picture p8: schematic DDR3.kicad_sch]

Parts:
C93, C98, C105, C106, C109, C110: .01uF; C_0402_1005Metric; MPN GRM155R71H103KA88J
C94, C95, C96, C97, C131: .1uF; C_0402_1005Metric; MPN CC0402KRX7R6BB104
C99: 100uF; C_1210_3225Metric; MPN JMK325ABJ107MM-P
C100, C127: 4.7uF; C_0402_1005Metric; MPN GRM155R60G475ME47D
C101, C102, C103, C104: .47uF; C_0402_1005Metric; MPN CC0402KRX5R5BB474
C125, C126, C128, C129, C130: 10uF; C_0603_1608Metric; MPN GRM188R61A106KE69J
D7: BLUE LED; C_0603_1608Metric; MPN VLMB1300-GS08
R25: 20k; R_0402_1005Metric; MPN RT0402BRD0720KL
R46, R49: 240 1%; R_0402_1005Metric; MPN RC0402FR-07240RL
R47, R48: 10k 1%; R_0402_1005Metric; MPN RC0402FR-0710KL
R50, R75, R76: 80.6 1%; R_0402_1005Metric; MPN RC0402FR-0780R6L
R51, R52, R53, R54, R55, R56, R57, R58, R59, R60, R61, R62, R63, R64, R65, R66, R67, R68, R69, R70, R71, R72, R73: 40.2 1%; R_0402_1005Metric; MPN RC0402FR-0740R2L
R74: 4.7k; R_0402_1005Metric; MPN RC0402JR-074K7L
R101: 100k; R_0402_1005Metric; MPN RC0402FR-07100KL
R102: 150; R_0402_1005Metric; MPN RC0402FR-07150RL
U8: TPS51200DRCR; VSON-10-1EP_3x3mm_P0.5mm_EP1.65x2.4mm_ThermalVias; MPN TPS51200DRCR; Digi-Key_PN 296-26978-1-ND
U15, U16: MT41K256M16HA-125_E; FBGA-96-DDR3-SDRAM; MPN MT41K256M16TW-107
U20: xc7z020clg484; BGA-484_19.0x19.0mm_Layout22x22_P0.80mm_dia0.40mm; MPN XC7Z020-1CLG484C

Connections:
+1V35: C94.1, C96.1, C99.1, C100.1, C101.1, C102.1, C103.1, C104.1, C109.1, C110.1, C125.1, C126.1, R47.1, R75.2, U8.2 (VLDOIN), U15.A1 (VDDQ), U15.A8 (VDDQ), U15.B2 (VDD), U15.C1 (VDDQ), U15.C9 (VDDQ), U15.D2 (VDDQ), U15.D9 (VDD), U15.E9 (VDDQ), U15.F1 (VDDQ), U15.G7 (VDD), U15.H2 (VDDQ), U15.H9 (VDDQ), U15.K2 (VDD), U15.K8 (VDD), U15.N1 (VDD), U15.N9 (VDD), U15.R1 (VDD), U15.R9 (VDD), U16.A1 (VDDQ), U16.A8 (VDDQ), U16.B2 (VDD), U16.C1 (VDDQ), U16.C9 (VDDQ), U16.D2 (VDDQ), U16.D9 (VDD), U16.E9 (VDDQ), U16.F1 (VDDQ), U16.G7 (VDD), U16.H2 (VDDQ), U16.H9 (VDDQ), U16.K2 (VDD), U16.K8 (VDD), U16.N1 (VDD), U16.N9 (VDD), U16.R1 (VDD), U16.R9 (VDD), U20.E2 (VCCO_DDR_502[9]), U20.F5 (VCCO_DDR_502[9]), U20.H1 (VCCO_DDR_502[9]), U20.J4 (VCCO_DDR_502[9]), U20.K7 (VCCO_DDR_502[9]), U20.M3 (VCCO_DDR_502[9]), U20.N6 (VCCO_DDR_502[9]), U20.R2 (VCCO_DDR_502[9]), U20.V1 (VCCO_DDR_502[9]); also elsewhere on the board
+3V3: C127.2, R25.1, R101.1, R102.2, U8.10 (VIN); also elsewhere on the board
/DDR3/PGOOD_LED: D7.2 (A), R102.1
/DDR3/VREF: C93.1, C94.2, C95.1, C96.2, C97.1, C98.1, C105.1, C106.1, R47.2, R48.1, U8.1 (REFIN), U15.H1 (VREFDQ), U15.M8 (VREFCA), U16.H1 (VREFDQ), U16.M8 (VREFCA), U20.H7 (PS_DDR_VREF0_502), U20.P7 (PS_DDR_VREF1_502)
/DDR3/ZQH: R46.1, U15.L8 (ZQ)
/DDR3/ZQL: R49.1, U16.L8 (ZQ)
DDR3_A0: R51.1, U15.N3 (A0), U16.N3 (A0), U20.M4 (PS_DDR_A0_502)
DDR3_A1: R52.1, U15.P7 (A1), U16.P7 (A1), U20.M5 (PS_DDR_A1_502)
DDR3_A2: R53.1, U15.P3 (A2), U16.P3 (A2), U20.K4 (PS_DDR_A2_502)
DDR3_A3: R54.1, U15.N2 (A3), U16.N2 (A3), U20.L4 (PS_DDR_A3_502)
DDR3_A4: R55.1, U15.P8 (A4), U16.P8 (A4), U20.K6 (PS_DDR_A4_502)
DDR3_A5: R56.1, U15.P2 (A5), U16.P2 (A5), U20.K5 (PS_DDR_A5_502)
DDR3_A6: R57.1, U15.R8 (A6), U16.R8 (A6), U20.J7 (PS_DDR_A6_502)
DDR3_A7: R58.1, U15.R2 (A7), U16.R2 (A7), U20.J6 (PS_DDR_A7_502)
DDR3_A8: R59.1, U15.T8 (A8), U16.T8 (A8), U20.J5 (PS_DDR_A8_502)
DDR3_A9: R60.1, U15.R3 (A9), U16.R3 (A9), U20.H5 (PS_DDR_A9_502)
DDR3_A10: R61.1, U15.L7 (A10/AP), U16.L7 (A10/AP), U20.J3 (PS_DDR_A10_502)
DDR3_A11: R62.1, U15.R7 (A11), U16.R7 (A11), U20.G5 (PS_DDR_A11_502)
DDR3_A12: R63.1, U15.N7 (A12/!BC), U16.N7 (A12/!BC), U20.H4 (PS_DDR_A12_502)
DDR3_A13: R64.1, U15.T3 (A13), U16.T3 (A13), U20.F4 (PS_DDR_A13_502)
DDR3_A14: R65.1, U15.T7 (A14), U16.T7 (A14), U20.G4 (PS_DDR_A14_502)
DDR3_BA0: R66.1, U15.M2 (BA0), U16.M2 (BA0), U20.L7 (PS_DDR_BA0_502)
DDR3_BA1: R67.1, U15.N8 (BA1), U16.N8 (BA1), U20.L6 (PS_DDR_BA1_502)
DDR3_BA2: R68.1, U15.M3 (BA2), U16.M3 (BA2), U20.M6 (PS_DDR_BA2_502)
DDR3_CAS#: R70.1, U15.K3 (~CAS), U16.K3 (~CAS), U20.P3 (PS_DDR_CAS_B_502)
DDR3_CKE: U15.K9 (CKE), U16.K9 (CKE), U20.V3 (PS_DDR_CKE_502)
DDR3_CK_N: R50.2, U15.K7 (~CK), U16.K7 (~CK), U20.N5 (PS_DDR_CKN_502)
DDR3_CK_P: R50.1, U15.J7 (CK), U16.J7 (CK), U20.N4 (PS_DDR_CKP_502)
DDR3_CS#: R73.1, U15.L2 (~CS), U16.L2 (~CS), U20.P6 (PS_DDR_CS_B_502)
DDR3_DM0: U16.E7 (LDM), U20.B1 (PS_DDR_DM0_502)
DDR3_DM1: U16.D3 (UDM), U20.H3 (PS_DDR_DM1_502)
DDR3_DM2: U15.E7 (LDM), U20.P1 (PS_DDR_DM2_502)
DDR3_DM3: U15.D3 (UDM), U20.AA2 (PS_DDR_DM3_502)
DDR3_DQ0: U16.E3 (DQ0), U20.C3 (PS_DDR_DQ1_502)
DDR3_DQ1: U16.F7 (DQ1), U20.F2 (PS_DDR_DQ6_502)
DDR3_DQ2: U16.F2 (DQ2), U20.B2 (PS_DDR_DQ2_502)
DDR3_DQ3: U16.F8 (DQ3), U20.F1 (PS_DDR_DQ7_502)
DDR3_DQ4: U16.H3 (DQ4), U20.E3 (PS_DDR_DQ4_502)
DDR3_DQ5: U16.H8 (DQ5), U20.E1 (PS_DDR_DQ5_502)
DDR3_DQ6: U16.G2 (DQ6), U20.D3 (PS_DDR_DQ3_502)
DDR3_DQ7: U16.H7 (DQ7), U20.D1 (PS_DDR_DQ0_502)
DDR3_DQ8: U16.B8 (DQ14), U20.L3 (PS_DDR_DQ12_502)
DDR3_DQ9: U16.A7 (DQ12), U20.L1 (PS_DDR_DQ10_502)
DDR3_DQ10: U16.C8 (DQ10), U20.L2 (PS_DDR_DQ11_502)
DDR3_DQ11: U16.C2 (DQ11), U20.J1 (PS_DDR_DQ14_502)
DDR3_DQ12: U16.C3 (DQ9), U20.K1 (PS_DDR_DQ13_502)
DDR3_DQ13: U16.A3 (DQ15), U20.G2 (PS_DDR_DQ8_502)
DDR3_DQ14: U16.D7 (DQ8), U20.K3 (PS_DDR_DQ15_502)
DDR3_DQ15: U16.A2 (DQ13), U20.G1 (PS_DDR_DQ9_502)
DDR3_DQ16: U15.E3 (DQ0), U20.T3 (PS_DDR_DQ17_502)
DDR3_DQ17: U15.F7 (DQ1), U20.T1 (PS_DDR_DQ19_502)
DDR3_DQ18: U15.F2 (DQ2), U20.M1 (PS_DDR_DQ16_502)
DDR3_DQ19: U15.F8 (DQ3), U20.T2 (PS_DDR_DQ21_502)
DDR3_DQ20: U15.H3 (DQ4), U20.M2 (PS_DDR_DQ22_502)
DDR3_DQ21: U15.H8 (DQ5), U20.R1 (PS_DDR_DQ23_502)
DDR3_DQ22: U15.G2 (DQ6), U20.N3 (PS_DDR_DQ18_502)
DDR3_DQ23: U15.H7 (DQ7), U20.R3 (PS_DDR_DQ20_502)
DDR3_DQ24: U15.D7 (DQ8), U20.AA3 (PS_DDR_DQ24_502)
DDR3_DQ25: U15.C3 (DQ9), U20.Y1 (PS_DDR_DQ31_502)
DDR3_DQ26: U15.C8 (DQ10), U20.Y3 (PS_DDR_DQ29_502)
DDR3_DQ27: U15.C2 (DQ11), U20.W1 (PS_DDR_DQ28_502)
DDR3_DQ28: U15.A7 (DQ12), U20.AA1 (PS_DDR_DQ26_502)
DDR3_DQ29: U15.A2 (DQ13), U20.U1 (PS_DDR_DQ25_502)
DDR3_DQ30: U15.B8 (DQ14), U20.W3 (PS_DDR_DQ30_502)
DDR3_DQ31: U15.A3 (DQ15), U20.U2 (PS_DDR_DQ27_502)
DDR3_DQS0_N: U16.G3 (~LDQS), U20.D2 (PS_DDR_DQS_N0_502)
DDR3_DQS0_P: U16.F3 (LDQS), U20.C2 (PS_DDR_DQS_P0_502)
DDR3_DQS1_N: U16.B7 (~UDQS), U20.J2 (PS_DDR_DQS_N1_502)
DDR3_DQS1_P: U16.C7 (UDQS), U20.H2 (PS_DDR_DQS_P1_502)
DDR3_DQS2_N: U15.G3 (~LDQS), U20.P2 (PS_DDR_DQS_N2_502)
DDR3_DQS2_P: U15.F3 (LDQS), U20.N2 (PS_DDR_DQS_P2_502)
DDR3_DQS3_N: U15.B7 (~UDQS), U20.W2 (PS_DDR_DQS_N3_502)
DDR3_DQS3_P: U15.C7 (UDQS), U20.V2 (PS_DDR_DQS_P3_502)
DDR3_DRST#: R74.1, U15.T2 (~RESET), U16.T2 (~RESET), U20.F3 (PS_DDR_DRST_B_502)
DDR3_ODT: R72.1, U15.K1 (ODT), U16.K1 (ODT), U20.P5 (PS_DDR_ODT_502)
DDR3_RAS#: R69.1, U15.J3 (~RAS), U16.J3 (~RAS), U20.R5 (PS_DDR_RAS_B_502)
DDR3_VTT: C128.1, C129.1, C130.1, R51.2, R52.2, R53.2, R54.2, R55.2, R56.2, R57.2, R58.2, R59.2, R60.2, R61.2, R62.2, R63.2, R64.2, R65.2, R66.2, R67.2, R68.2, R69.2, R70.2, R71.2, R72.2, R73.2, U8.3 (VO), U8.5 (VOSNS)
DDR3_VTT_EN: R25.2, U8.7 (EN); also elsewhere on the board
DDR3_WE#: R71.1, U15.L3 (~WE), U16.L3 (~WE), U20.R4 (PS_DDR_WE_B_502)
GND: C93.2, C95.2, C97.2, C98.2, C99.2, C100.2, C101.2, C102.2, C103.2, C104.2, C105.2, C106.2, C109.2, C110.2, C125.2, C126.2, C127.1, C128.2, C129.2, C130.2, C131.2, R46.2, R48.2, R49.2, R74.2, R76.2, U8.4 (PGND), U8.8 (GND), U8.11, U15.A9 (VSS), U15.B1 (VSSQ), U15.B3 (VSS), U15.B9 (VSSQ), U15.D1 (VSSQ), U15.D8 (VSSQ), U15.E1 (VSS), U15.E2 (VSSQ), U15.E8 (VSSQ), U15.F9 (VSSQ), U15.G1 (VSSQ), U15.G8 (VSS), U15.G9 (VSSQ), U15.J2 (VSS), U15.J8 (VSS), U15.M1 (VSS), U15.M9 (VSS), U15.P1 (VSS), U15.P9 (VSS), U15.T1 (VSS), U15.T9 (VSS), U16.A9 (VSS), U16.B1 (VSSQ), U16.B3 (VSS), U16.B9 (VSSQ), U16.D1 (VSSQ), U16.D8 (VSSQ), U16.E1 (VSS), U16.E2 (VSSQ), U16.E8 (VSSQ), U16.F9 (VSSQ), U16.G1 (VSSQ), U16.G8 (VSS), U16.G9 (VSSQ), U16.J2 (VSS), U16.J8 (VSS), U16.M1 (VSS), U16.M9 (VSS), U16.P1 (VSS), U16.P9 (VSS), U16.T1 (VSS), U16.T9 (VSS); also elsewhere on the board
unnamed: D7.1 (K), R101.2, U8.9 (PGOOD)
unnamed: C131.1, U8.6 (REFOUT)
unnamed: R75.1, U20.M7 (PS_DDR_VRN_502)
unnamed: R76.1, U20.N7 (PS_DDR_VRP_502)

Notes on the sheet:
1066 Mb/s (533 MHz) Should be attainable by all speed grades of Zynq through the PS DDR interface This precludes use of internal Vref
DDR3L trace impedance: 40ohm differential 80ohm single
Terminations as described in UG933 and shown in ZC702 schematic
Pinout identical to TW 96-ball FBGA variant
RECOMMENDED: Fly-by and point-to-point routing is recommended for optimal memory performance
DDR3
Differential termination at end / first break This is the only P-to-N termination in ZC702 DDR3

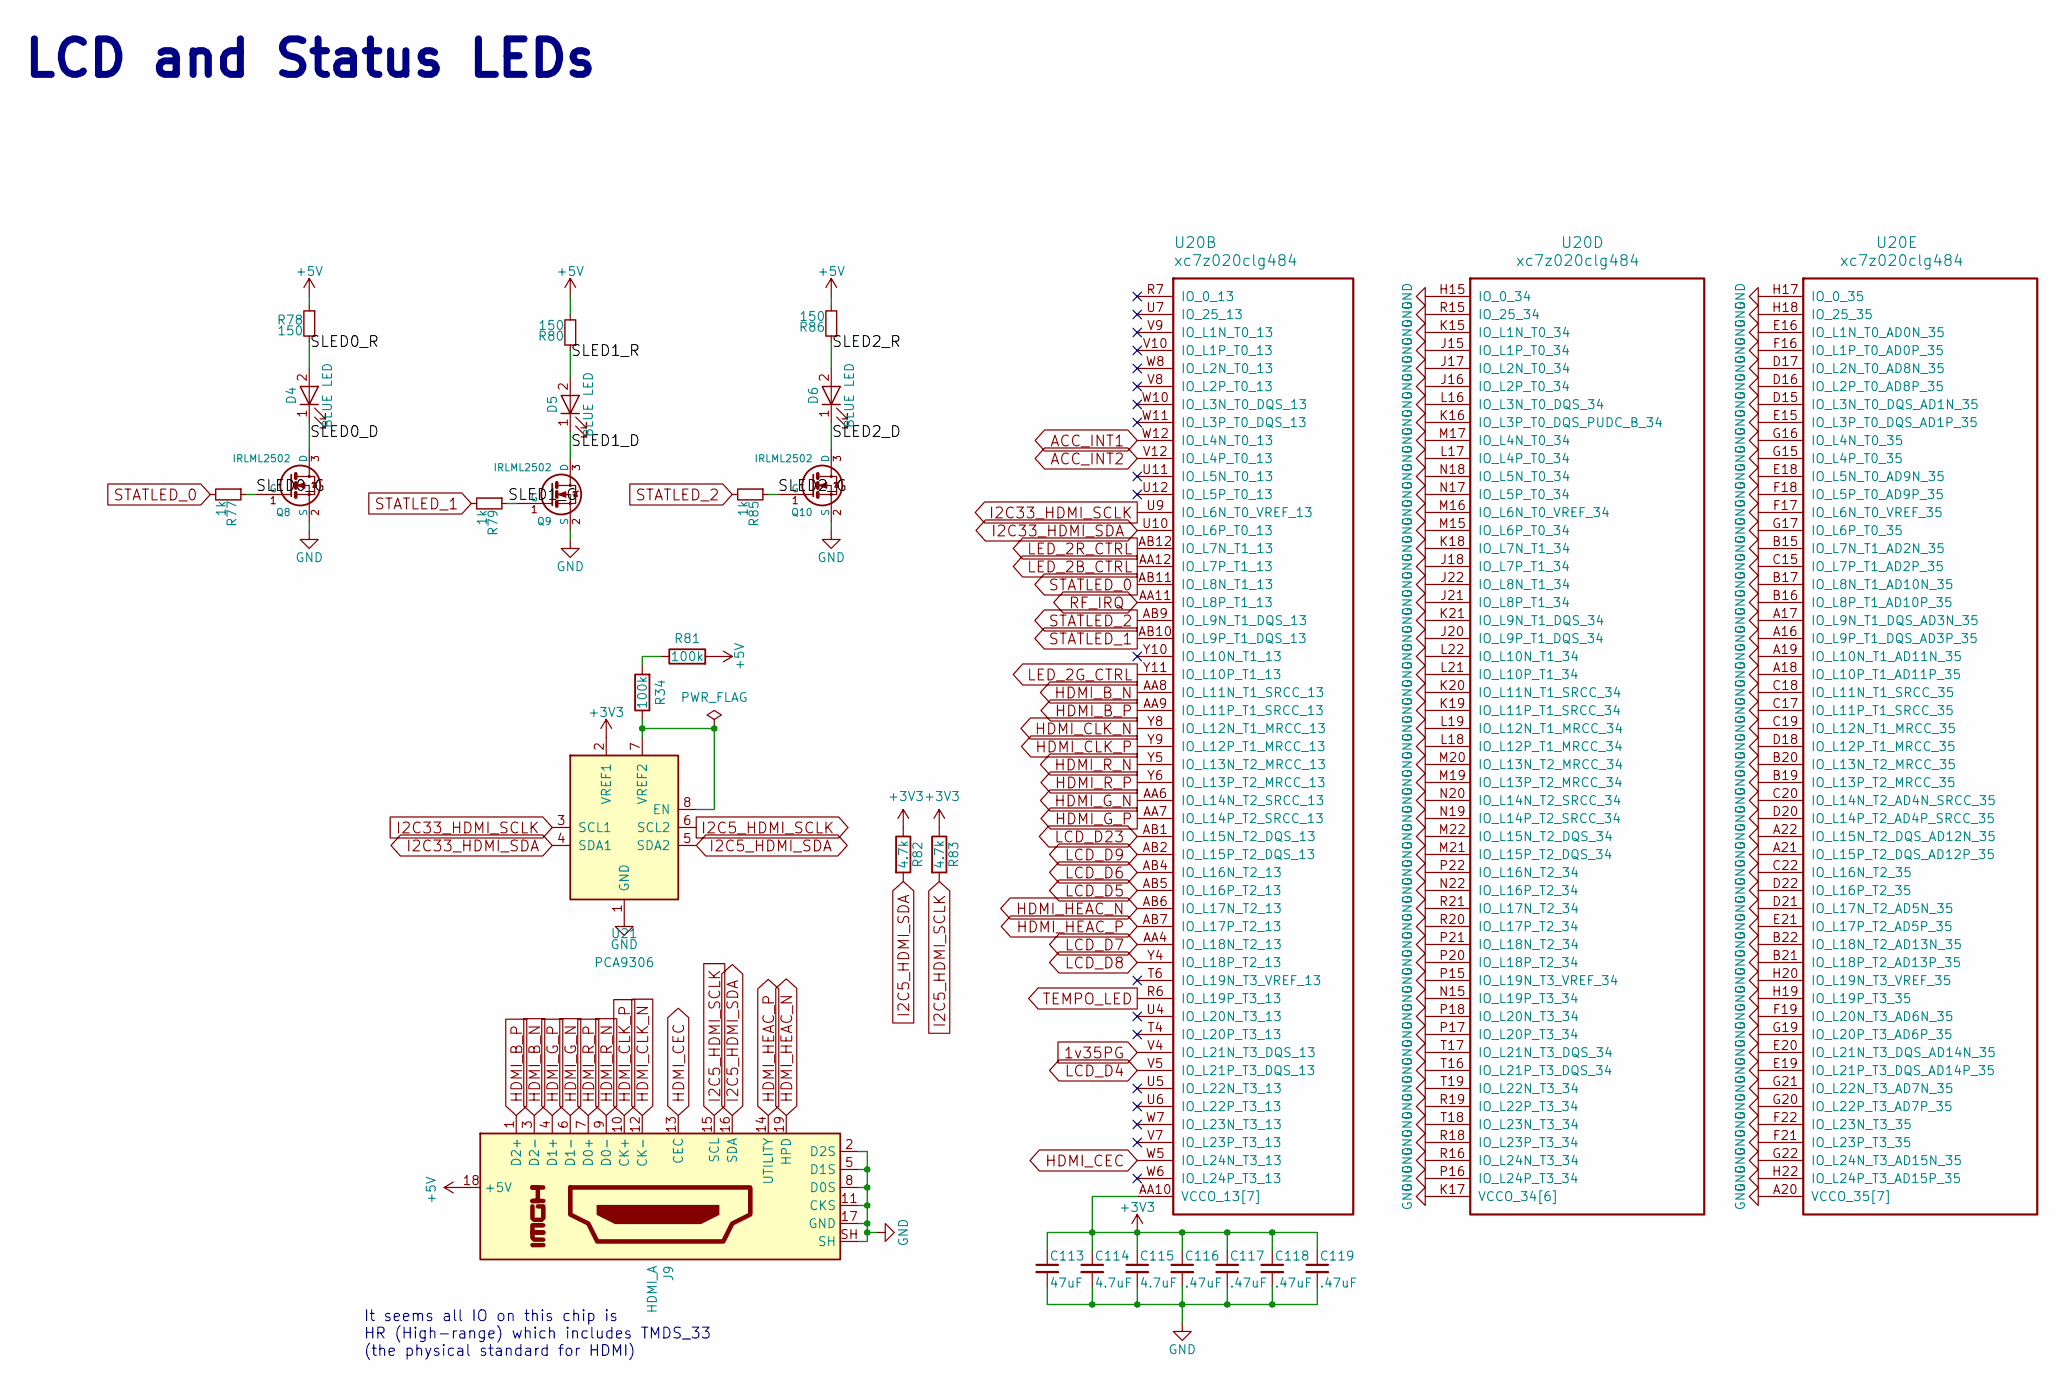
[picture p9: schematic LCD50.kicad_sch]

Parts:
C113: 47uF; C_1210_3225Metric; MPN GRM32ER70J476ME20L
C114, C115: 4.7uF; C_0402_1005Metric; MPN GRM155R60G475ME47D
C116, C117, C118, C119: .47uF; C_0402_1005Metric; MPN CC0402KRX5R5BB474
D4, D5, D6: BLUE LED; C_0603_1608Metric; MPN VLMB1300-GS08
J9: HDMI_A; 10029449-111RLF; MPN 10029449-111RLF
Q8, Q9, Q10: IRLML2502; SOT-23; MPN IRLML2502TRPBF
R34, R81: 100k; R_0402_1005Metric; MPN RC0402FR-07100KL
R77, R79, R85: 1k; R_0402_1005Metric; MPN RC0402FR-071KL
R78, R80, R86: 150; R_0402_1005Metric; MPN RC0402FR-07150RL
R82, R83: 4.7k; R_0402_1005Metric; MPN RC0402JR-074K7L
U20: xc7z020clg484; BGA-484_19.0x19.0mm_Layout22x22_P0.80mm_dia0.40mm; MPN XC7Z020-1CLG484C
U21: PCA9306; SSOP-8_2.95x2.8mm_P0.65mm; MPN PCA9306DCTR

Connections:
1v35PG: U20.V4 (IO_L21N_T3_DQS_13); also elsewhere on the board
+3V3: C113.1, C114.1, C115.1, C116.1, C117.1, C118.1, C119.1, R82.1, R83.1, U20.AA10 (VCCO_13[7]), U20.AB3 (VCCO_13[7]), U20.T5 (VCCO_13[7]), U20.U8 (VCCO_13[7]), U20.V11 (VCCO_13[7]), U20.W4 (VCCO_13[7]), U20.Y7 (VCCO_13[7]), U21.2 (VREF1); also elsewhere on the board
+5V: J9.18 (+5V), R78.1, R80.2, R81.2, R86.2; also elsewhere on the board
/LCD50/SLED0_D: D4.1 (K), Q8.3 (D)
/LCD50/SLED0_G: Q8.1 (G), R77.1
/LCD50/SLED0_R: D4.2 (A), R78.2
/LCD50/SLED1_D: D5.1 (K), Q9.3 (D)
/LCD50/SLED1_G: Q9.1 (G), R79.1
/LCD50/SLED1_R: D5.2 (A), R80.1
/LCD50/SLED2_D: D6.1 (K), Q10.3 (D)
/LCD50/SLED2_G: Q10.1 (G), R85.1
/LCD50/SLED2_R: D6.2 (A), R86.1
ACC_INT1: U20.W12 (IO_L4N_T0_13); also elsewhere on the board
ACC_INT2: U20.V12 (IO_L4P_T0_13); also elsewhere on the board
GND: C113.2, C114.2, C115.2, C116.2, C117.2, C118.2, C119.2, J9.2 (D2S), J9.5 (D1S), J9.8 (D0S), J9.11 (CKS), J9.17 (GND), J9.SH, Q8.2 (S), Q9.2 (S), Q10.2 (S), U20.A16 (IO_L9P_T1_DQS_AD3P_35), U20.A17 (IO_L9N_T1_DQS_AD3N_35), U20.A18 (IO_L10P_T1_AD11P_35), U20.A19 (IO_L10N_T1_AD11N_35), U20.A20 (VCCO_35[7]), U20.A21 (IO_L15P_T2_DQS_AD12P_35), U20.A22 (IO_L15N_T2_DQS_AD12N_35), U20.B15 (IO_L7N_T1_AD2N_35), U20.B16 (IO_L8P_T1_AD10P_35), U20.B17 (IO_L8N_T1_AD10N_35), U20.B19 (IO_L13P_T2_MRCC_35), U20.B20 (IO_L13N_T2_MRCC_35), U20.B21 (IO_L18P_T2_AD13P_35), U20.B22 (IO_L18N_T2_AD13N_35), U20.C15 (IO_L7P_T1_AD2P_35), U20.C16 (VCCO_35[7]), U20.C17 (IO_L11P_T1_SRCC_35), U20.C18 (IO_L11N_T1_SRCC_35), U20.C19 (IO_L12N_T1_MRCC_35), U20.C20 (IO_L14N_T2_AD4N_SRCC_35), U20.C22 (IO_L16N_T2_35), U20.D15 (IO_L3N_T0_DQS_AD1N_35), U20.D16 (IO_L2P_T0_AD8P_35), U20.D17 (IO_L2N_T0_AD8N_35), U20.D18 (IO_L12P_T1_MRCC_35), U20.D19 (VCCO_35[7]), U20.D20 (IO_L14P_T2_AD4P_SRCC_35), U20.D21 (IO_L17N_T2_AD5N_35), U20.D22 (IO_L16P_T2_35), U20.E15 (IO_L3P_T0_DQS_AD1P_35), U20.E16 (IO_L1N_T0_AD0N_35), U20.E18 (IO_L5N_T0_AD9N_35), U20.E19 (IO_L21P_T3_DQS_AD14P_35), U20.E20 (IO_L21N_T3_DQS_AD14N_35), U20.E21 (IO_L17P_T2_AD5P_35), U20.E22 (VCCO_35[7]), U20.F15 (VCCO_35[7]), U20.F16 (IO_L1P_T0_AD0P_35), U20.F17 (IO_L6N_T0_VREF_35), U20.F18 (IO_L5P_T0_AD9P_35), U20.F19 (IO_L20N_T3_AD6N_35), U20.F21 (IO_L23P_T3_35), U20.F22 (IO_L23N_T3_35), U20.G15 (IO_L4P_T0_35), U20.G16 (IO_L4N_T0_35), U20.G17 (IO_L6P_T0_35), U20.G18 (VCCO_35[7]), U20.G19 (IO_L20P_T3_AD6P_35), U20.G20 (IO_L22P_T3_AD7P_35), U20.G21 (IO_L22N_T3_AD7N_35), U20.G22 (IO_L24N_T3_AD15N_35), U20.H15 (IO_0_34), U20.H17 (IO_0_35), U20.H18 (IO_25_35), U20.H19 (IO_L19P_T3_35), U20.H20 (IO_L19N_T3_VREF_35), U20.H21 (VCCO_35[7]), U20.H22 (IO_L24P_T3_AD15P_35), U20.J15 (IO_L1P_T0_34), U20.J16 (IO_L2P_T0_34), U20.J17 (IO_L2N_T0_34), U20.J18 (IO_L7P_T1_34), U20.J20 (IO_L9P_T1_DQS_34), U20.J21 (IO_L8P_T1_34), U20.J22 (IO_L8N_T1_34), U20.K15 (IO_L1N_T0_34), U20.K16 (IO_L3P_T0_DQS_PUDC_B_34), U20.K17 (VCCO_34[6]), U20.K18 (IO_L7N_T1_34), U20.K19 (IO_L11P_T1_SRCC_34), U20.K20 (IO_L11N_T1_SRCC_34), U20.K21 (IO_L9N_T1_DQS_34), U20.L16 (IO_L3N_T0_DQS_34), U20.L17 (IO_L4P_T0_34), U20.L18 (IO_L12P_T1_MRCC_34), U20.L19 (IO_L12N_T1_MRCC_34), U20.L20 (VCCO_34[6]), U20.L21 (IO_L10P_T1_34), U20.L22 (IO_L10N_T1_34), U20.M15 (IO_L6P_T0_34), U20.M16 (IO_L6N_T0_VREF_34), U20.M17 (IO_L4N_T0_34), U20.M19 (IO_L13P_T2_MRCC_34), U20.M20 (IO_L13N_T2_MRCC_34), U20.M21 (IO_L15P_T2_DQS_34), U20.M22 (IO_L15N_T2_DQS_34), U20.N15 (IO_L19P_T3_34), U20.N16 (VCCO_34[6]), U20.N17 (IO_L5P_T0_34), U20.N18 (IO_L5N_T0_34), U20.N19 (IO_L14P_T2_SRCC_34), U20.N20 (IO_L14N_T2_SRCC_34), U20.N22 (IO_L16P_T2_34), U20.P15 (IO_L19N_T3_VREF_34), U20.P16 (IO_L24P_T3_34), U20.P17 (IO_L20P_T3_34), U20.P18 (IO_L20N_T3_34), U20.P19 (VCCO_34[6]), U20.P20 (IO_L18P_T2_34), U20.P21 (IO_L18N_T2_34), U20.P22 (IO_L16N_T2_34), U20.R15 (IO_25_34), U20.R16 (IO_L24N_T3_34), U20.R18 (IO_L23P_T3_34), U20.R19 (IO_L22P_T3_34), U20.R20 (IO_L17P_T2_34), U20.R21 (IO_L17N_T2_34), U20.R22 (VCCO_34[6]), U20.T15 (VCCO_34[6]), U20.T16 (IO_L21P_T3_DQS_34), U20.T17 (IO_L21N_T3_DQS_34), U20.T18 (IO_L23N_T3_34), U20.T19 (IO_L22N_T3_34), U21.1 (GND); also elsewhere on the board
HDMI_B_N: J9.3 (D2-), U20.AA8 (IO_L11N_T1_SRCC_13)
HDMI_B_P: J9.1 (D2+), U20.AA9 (IO_L11P_T1_SRCC_13)
HDMI_CEC: J9.13 (CEC), U20.W5 (IO_L24N_T3_13)
HDMI_CLK_N: J9.12 (CK-), U20.Y8 (IO_L12N_T1_MRCC_13)
HDMI_CLK_P: J9.10 (CK+), U20.Y9 (IO_L12P_T1_MRCC_13)
HDMI_G_N: J9.6 (D1-), U20.AA6 (IO_L14N_T2_SRCC_13)
HDMI_G_P: J9.4 (D1+), U20.AA7 (IO_L14P_T2_SRCC_13)
HDMI_HEAC_N: J9.19 (HPD), U20.AB6 (IO_L17N_T2_13)
HDMI_HEAC_P: J9.14 (UTILITY), U20.AB7 (IO_L17P_T2_13)
HDMI_R_N: J9.9 (D0-), U20.Y5 (IO_L13N_T2_MRCC_13)
HDMI_R_P: J9.7 (D0+), U20.Y6 (IO_L13P_T2_MRCC_13)
I2C5_HDMI_SCLK: J9.15 (SCL), R83.2, U21.6 (SCL2)
I2C5_HDMI_SDA: J9.16 (SDA), R82.2, U21.5 (SDA2)
I2C33_HDMI_SCLK: U20.U9 (IO_L6N_T0_VREF_13), U21.3 (SCL1)
I2C33_HDMI_SDA: U20.U10 (IO_L6P_T0_13), U21.4 (SDA1)
LCD_D4: U20.V5 (IO_L21P_T3_DQS_13)
LCD_D5: U20.AB5 (IO_L16P_T2_13)
LCD_D6: U20.AB4 (IO_L16N_T2_13)
LCD_D7: U20.AA4 (IO_L18N_T2_13)
LCD_D8: U20.Y4 (IO_L18P_T2_13)
LCD_D9: U20.AB2 (IO_L15P_T2_DQS_13)
LCD_D23: U20.AB1 (IO_L15N_T2_DQS_13)
LED_2B_CTRL: U20.AA12 (IO_L7P_T1_13)
LED_2G_CTRL: U20.Y11 (IO_L10P_T1_13)
LED_2R_CTRL: U20.AB12 (IO_L7N_T1_13)
unnamed: R34.2, R81.1
unnamed: R34.1, U21.7 (VREF2), U21.8 (EN)
RF_IRQ: U20.AA11 (IO_L8P_T1_13); also elsewhere on the board
STATLED_0: R77.2, U20.AB11 (IO_L8N_T1_13)
STATLED_1: R79.2, U20.AB10 (IO_L9P_T1_DQS_13)
STATLED_2: R85.2, U20.AB9 (IO_L9N_T1_DQS_13)
TEMPO_LED: U20.R6 (IO_L19P_T3_13); also elsewhere on the board

Notes on the sheet:
It seems all IO on this chip is HR (High-range) which includes TMDS_33 (the physical standard for HDMI)
LCD and Status LEDs

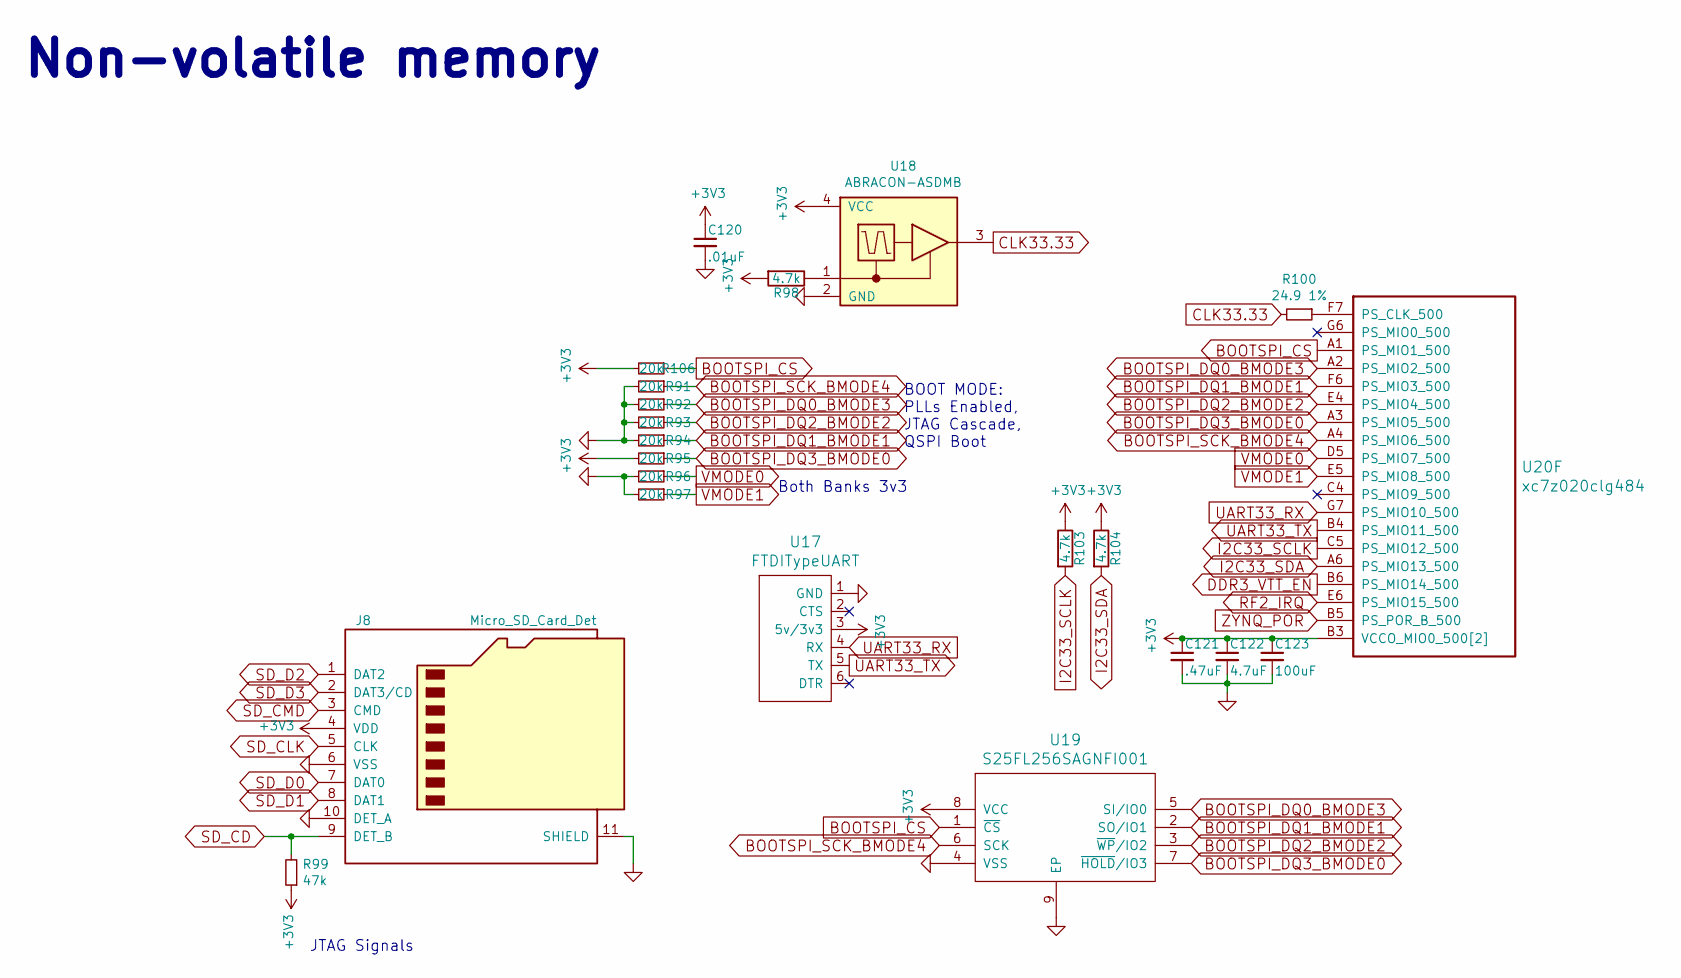
[picture p10: schematic Storage.kicad_sch]

Parts:
C120: .01uF; C_0402_1005Metric; MPN GRM155R71H103KA88J
C121: .47uF; C_0402_1005Metric; MPN CC0402KRX5R5BB474
C122: 4.7uF; C_0402_1005Metric; MPN GRM155R60G475ME47D
C123: 100uF; C_1210_3225Metric; MPN JMK325ABJ107MM-P
J8: Micro_SD_Card_Det; AMPHENOL-114-00841-68; MPN 114-00841-68
R91, R92, R93, R94, R95, R96, R97, R106: 20k; R_0402_1005Metric; MPN RT0402BRD0720KL
R98, R103, R104: 4.7k; R_0402_1005Metric; MPN RC0402JR-074K7L
R99: 47k; R_0402_1005Metric; MPN RC0402FR-0747KL
R100: 24.9 1%; R_0402_1005Metric; MPN RC0402FR-0724K9L
U17: FTDITypeUART; FTDI_CONN
U18: ABRACON-ASDMB; XTAL_ASDMB-24.000MHZ-LC-T; MPN ASDMB-24.000MHZ-LC-T
U19: S25FL256SAGNFI001; DFN-8-1EP_2x2mm_P0.5mm_EP0.7x1.3mm; MPN S25FL256SAGNFI001
U20: xc7z020clg484; BGA-484_19.0x19.0mm_Layout22x22_P0.80mm_dia0.40mm; MPN XC7Z020-1CLG484C

Connections:
+3V3: C120.1, C121.1, C122.1, C123.1, J8.4 (VDD), R95.2, R98.2, R99.1, R103.1, R104.1, R106.2, U17.3 (5v/3v3), U18.4 (VCC), U19.8 (VCC), U20.B3 (VCCO_MIO0_500[2]), U20.C6 (VCCO_MIO0_500[2]); also elsewhere on the board
BOOTSPI_CS: R106.1, U19.1 (~CS), U20.A1 (PS_MIO1_500)
BOOTSPI_DQ0_BMODE3: R92.1, U19.5 (SI/IO0), U20.A2 (PS_MIO2_500)
BOOTSPI_DQ1_BMODE1: R94.1, U19.2 (SO/IO1), U20.F6 (PS_MIO3_500)
BOOTSPI_DQ2_BMODE2: R93.1, U19.3 (~WP/IO2), U20.E4 (PS_MIO4_500)
BOOTSPI_DQ3_BMODE0: R95.1, U19.7 (~HOLD/IO3), U20.A3 (PS_MIO5_500)
BOOTSPI_SCK_BMODE4: R91.1, U19.6 (SCK), U20.A4 (PS_MIO6_500)
CLK33.33: R100.2, U18.3 (OUT)
DDR3_VTT_EN: U20.B6 (PS_MIO14_500); also elsewhere on the board
GND: C120.2, C121.2, C122.2, C123.2, J8.6 (VSS), J8.10 (DET_A), J8.11 (SHIELD), R91.2, R92.2, R93.2, R94.2, R96.2, R97.2, U17.1 (GND), U18.2 (GND), U19.4 (VSS), U19.9 (EP); also elsewhere on the board
I2C33_SCLK: R103.2, U20.C5 (PS_MIO12_500); also elsewhere on the board
I2C33_SDA: R104.2, U20.A6 (PS_MIO13_500); also elsewhere on the board
unnamed: R98.1, U18.1 (OE)
unnamed: R100.1, U20.F7 (PS_CLK_500)
RF2_IRQ: U20.E6 (PS_MIO15_500); also elsewhere on the board
SD_CD: J8.9 (DET_B), R99.2; also elsewhere on the board
SD_CLK: J8.5 (CLK); also elsewhere on the board
SD_CMD: J8.3 (CMD); also elsewhere on the board
SD_D0: J8.7 (DAT0); also elsewhere on the board
SD_D1: J8.8 (DAT1); also elsewhere on the board
SD_D2: J8.1 (DAT2); also elsewhere on the board
SD_D3: J8.2 (DAT3/CD); also elsewhere on the board
UART33_RX: U17.4 (RX), U20.G7 (PS_MIO10_500)
UART33_TX: U17.5 (TX), U20.B4 (PS_MIO11_500)
VMODE0: R96.1, U20.D5 (PS_MIO7_500)
VMODE1: R97.1, U20.E5 (PS_MIO8_500)
ZYNQ_POR: U20.B5 (PS_POR_B_500); also elsewhere on the board

Notes on the sheet:
BOOT MODE: PLLs Enabled, JTAG Cascade, QSPI Boot
Both Banks 3v3
JTAG Signals
Non-volatile memory

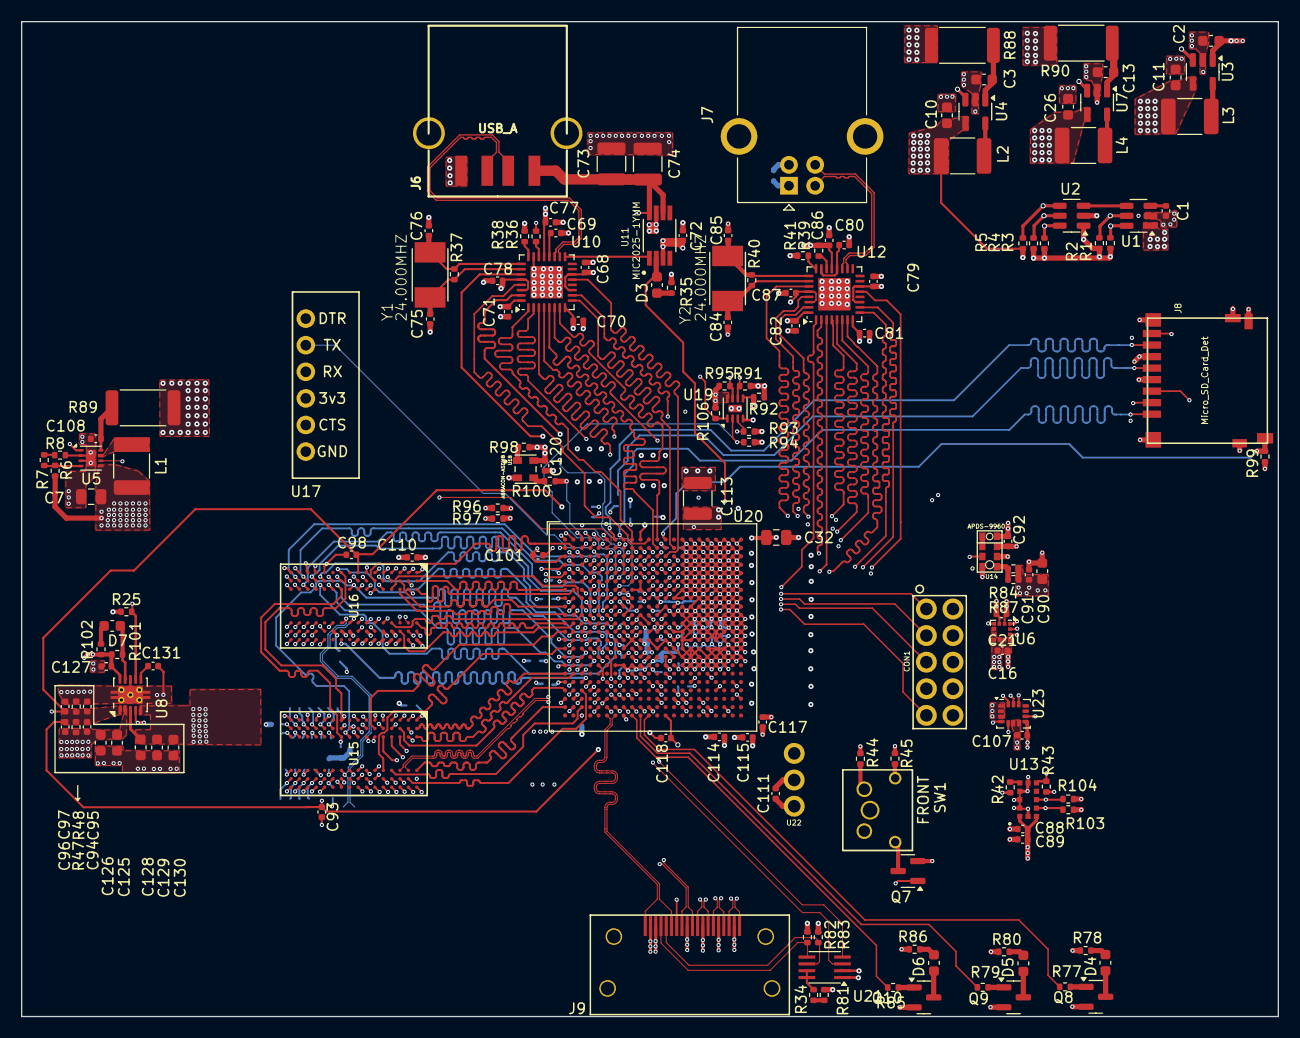
[picture p11: board DFTBoard.kicad_pcb from above]

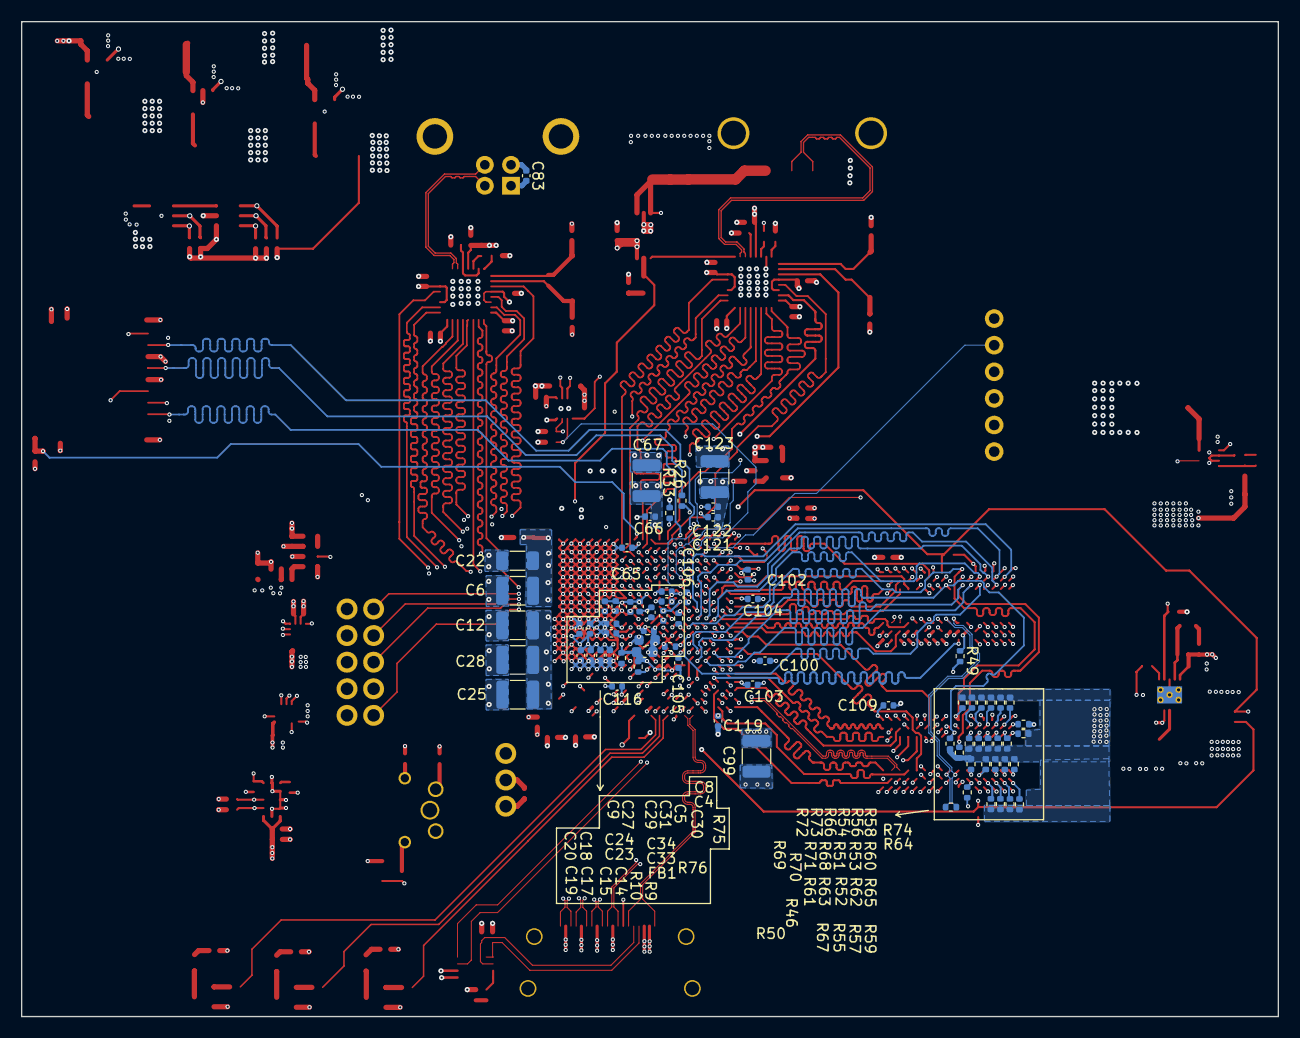
[picture p12: board DFTBoard.kicad_pcb from below]

Board: 8 copper layers, 120.0 x 95.0 mm, 228 parts (74 on the bottom side), 222 nets.
